granum-space/cansat-2017-2018/results/search-region/radius.png

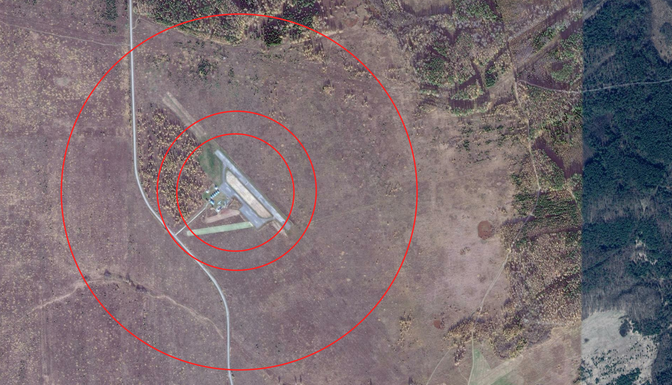
results/search-region/radius.png
