granum-space/cansat-2017-2018/documents/картинки/старые/gps.png

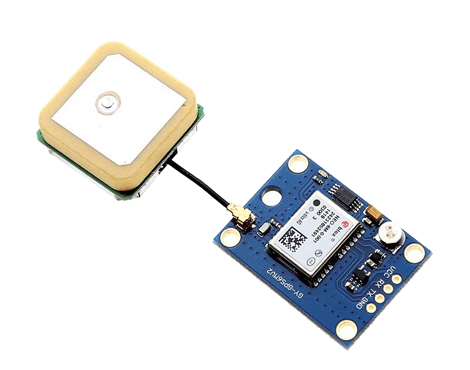
documents/картинки/старые/gps.png
