granum-space/cansat-2017-2018/README.md

# cansat-2018
Проект команды Granum чемпионата Cansat в России 2017-2018 года
