granum-space/cansat-2017-2018/src/board/servo_ctl/Project/stm8_granum_servo_ctl/readme.txt

Простой проект для управления сервой по i2c
