granum-space/cansat-2017-2018/research/archimedes screw/README.md

Исследование архимедова винта для подъема грунта для анализа
