granum-space/cansat-2017-2018/documents/mpu6000.jpg

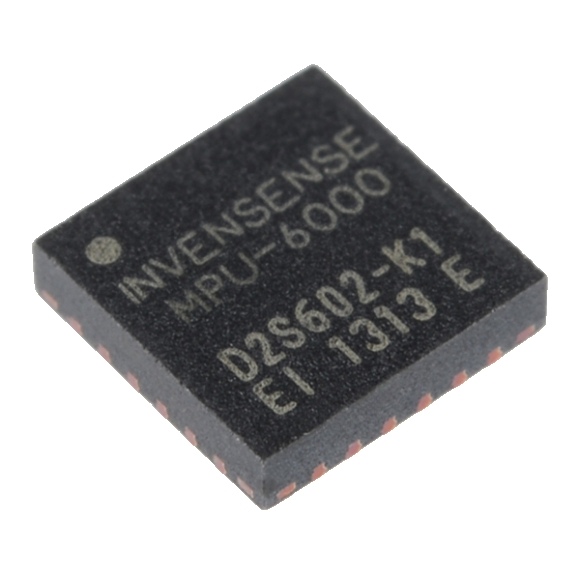
documents/mpu6000.jpg
