granum-space/cansat-2017-2018/documents/исходники схем/Линзы-на-слайд-2.png

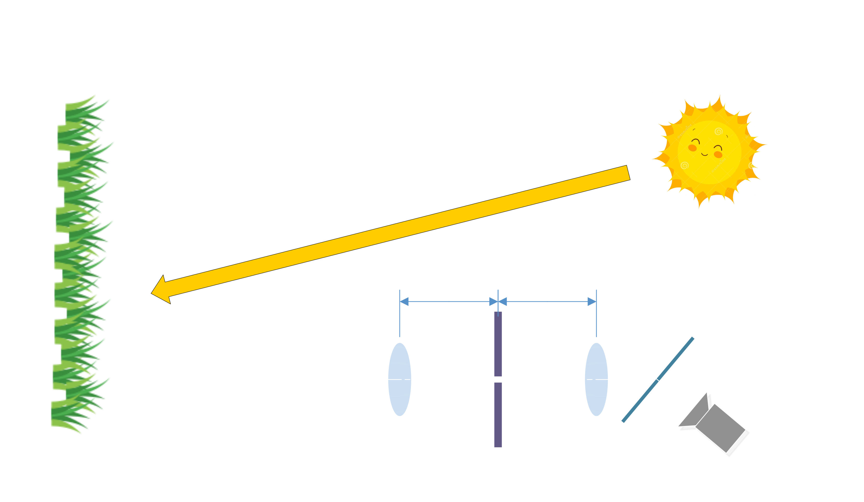
documents/исходники схем/Линзы-на-слайд-2.png
