granum-space/cansat-2017-2018/documents/исходники схем/Линзы-на-слайд.png

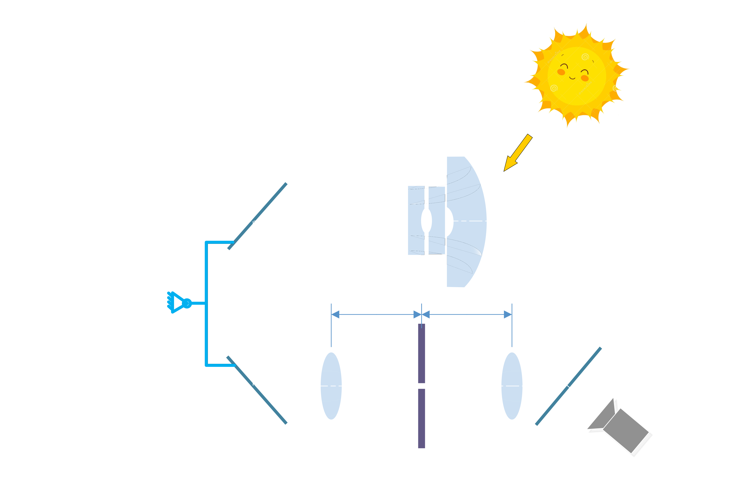
documents/исходники схем/Линзы-на-слайд.png
