granum-space/cansat-2017-2018/documents/исходники схем/Линзы-ПЗ.png

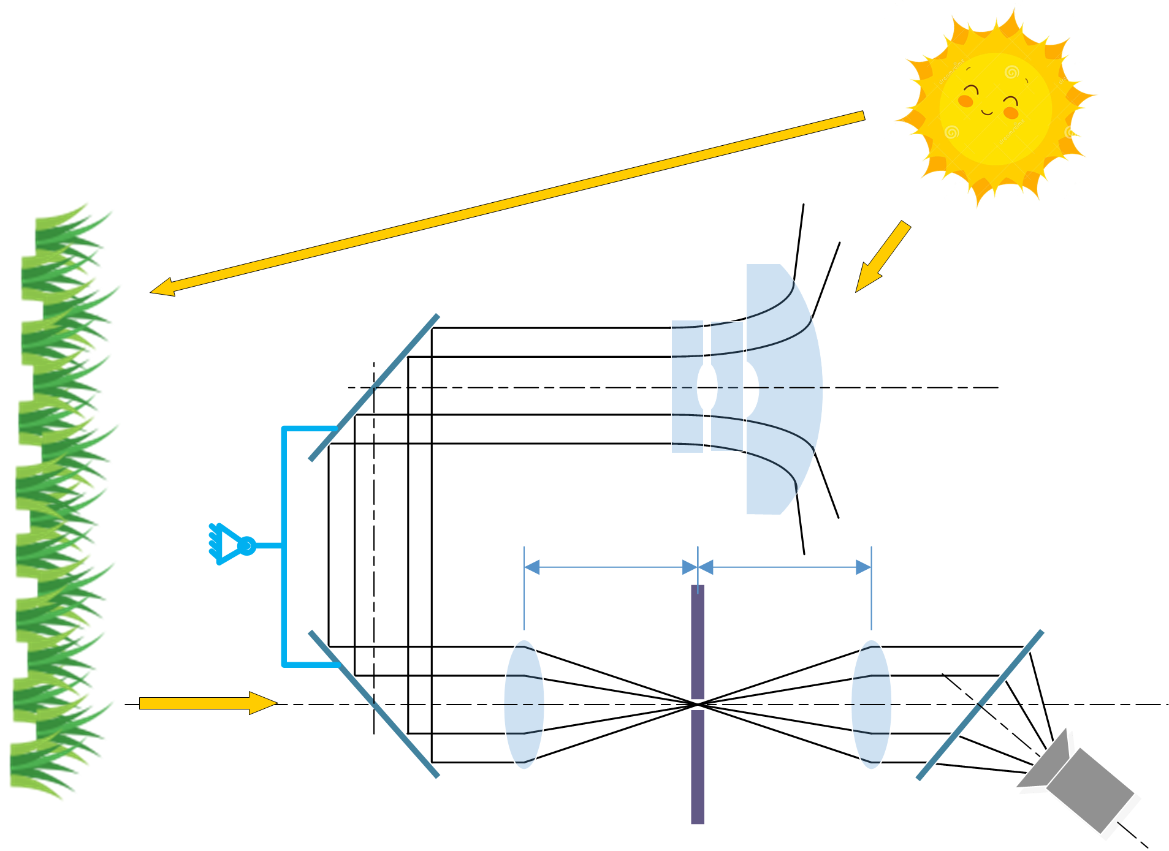
documents/исходники схем/Линзы-ПЗ.png
