granum-space/cansat-2017-2018/documents/картинки/bmp280.png

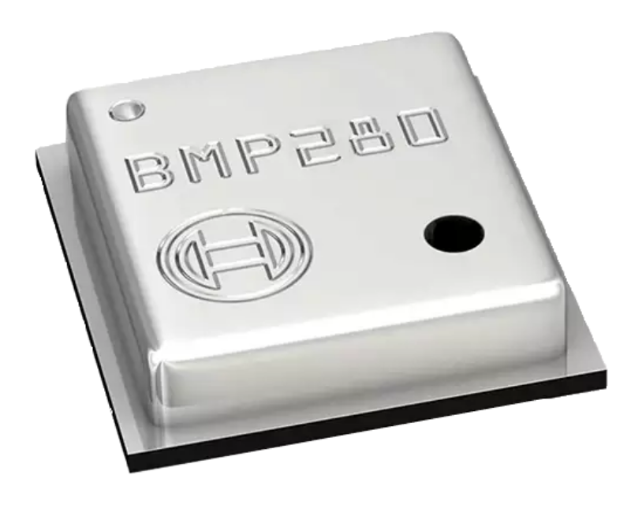
documents/картинки/bmp280.png
