granum-space/cansat-2017-2018/documents/картинки/microsd.png

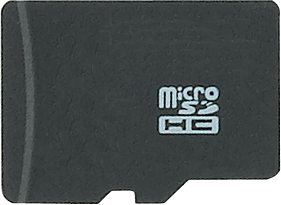
documents/картинки/microsd.png
