granum-space/cansat-2017-2018/documents/картинки/UART cam.jpg

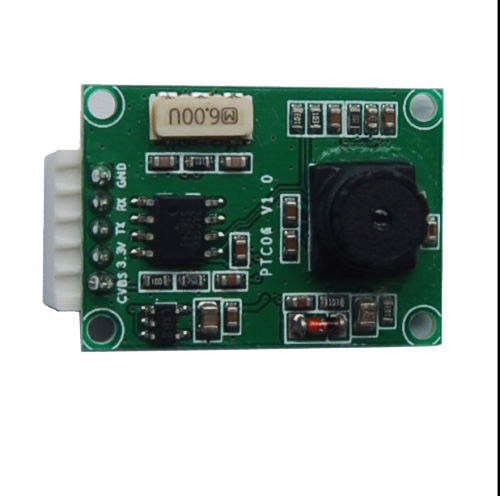
documents/картинки/UART cam.jpg
