granum-space/cansat-2017-2018/documents/картинки/Интернет.png

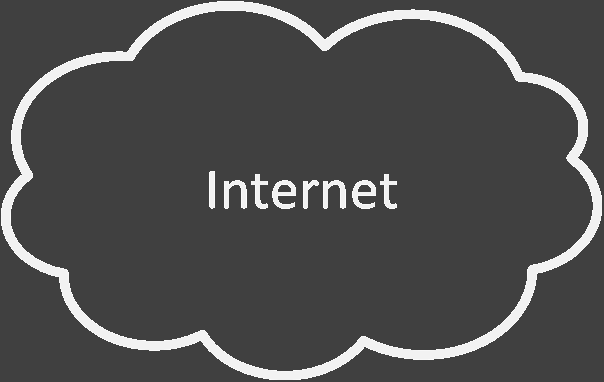
documents/картинки/Интернет.png
