granum-space/cansat-2017-2018/documents/картинки/Кабельная сеть.png

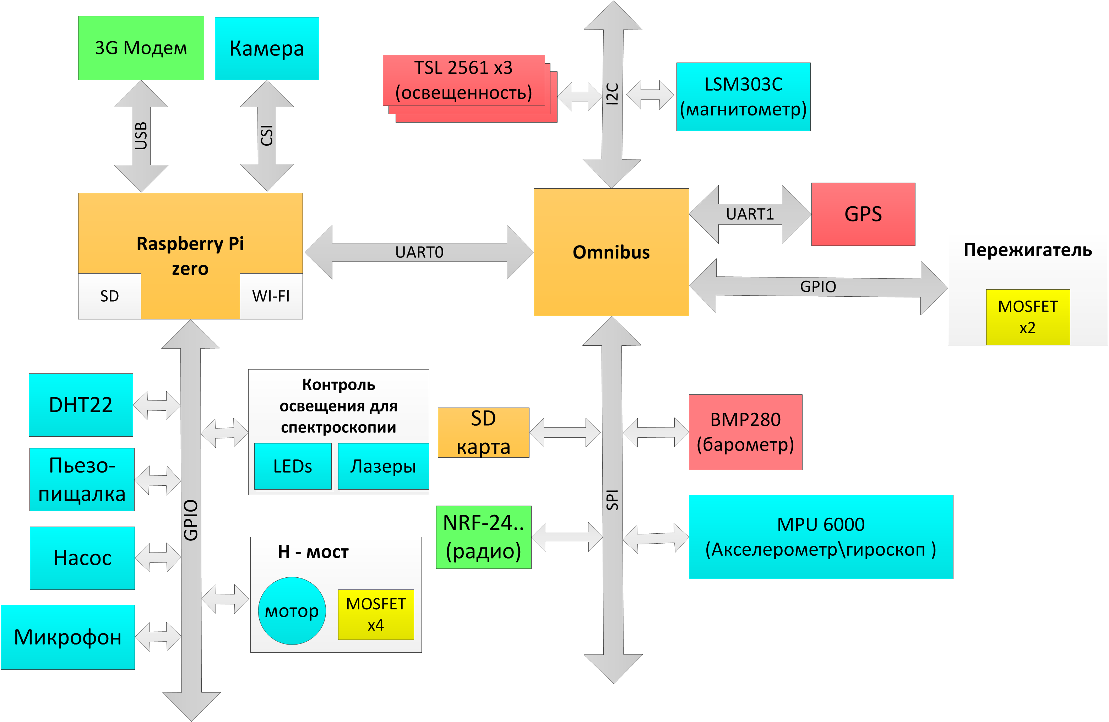
documents/картинки/Кабельная сеть.png
