granum-space/cansat-2017-2018/documents/картинки/наземка.png

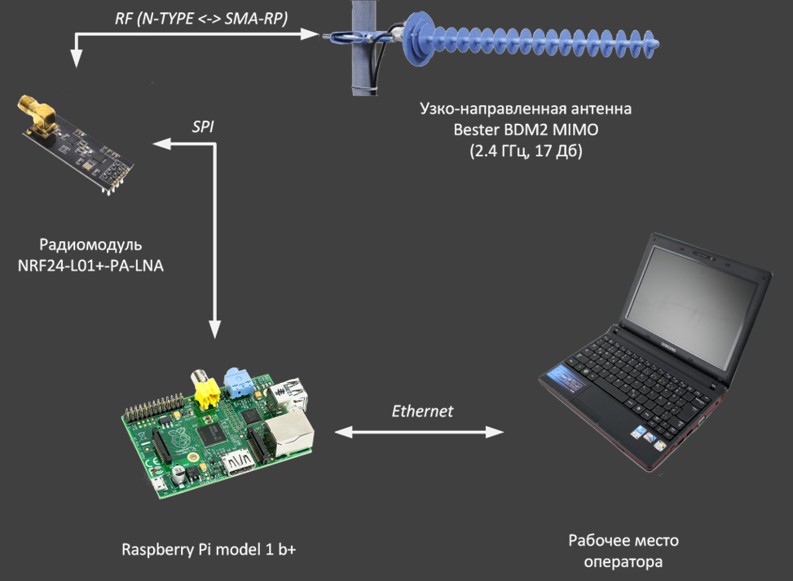
documents/картинки/наземка.png
