granum-space/cansat-2017-2018/documents/картинки/Наземная инфраструктура (для ПЗ).png

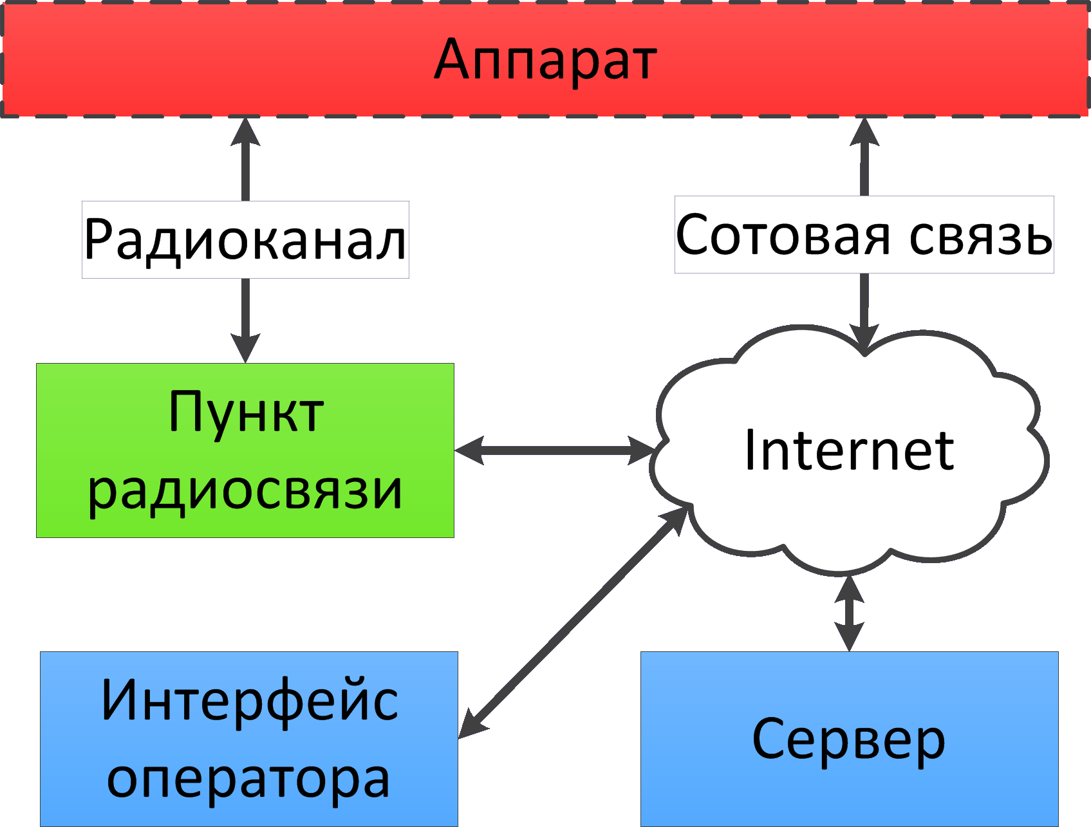
documents/картинки/Наземная инфраструктура (для ПЗ).png
