granum-space/cansat-2017-2018/documents/картинки/Наземная инфраструктура (для презентации).png

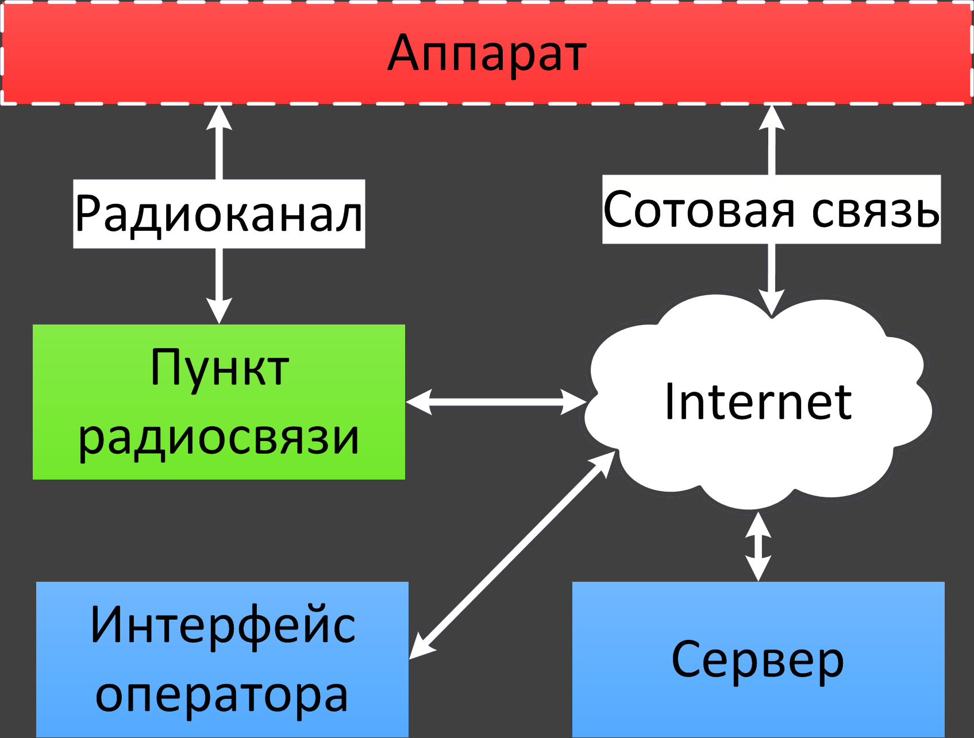
documents/картинки/Наземная инфраструктура (для презентации).png
