granum-space/cansat-2017-2018/documents/картинки/ПО презентация.png

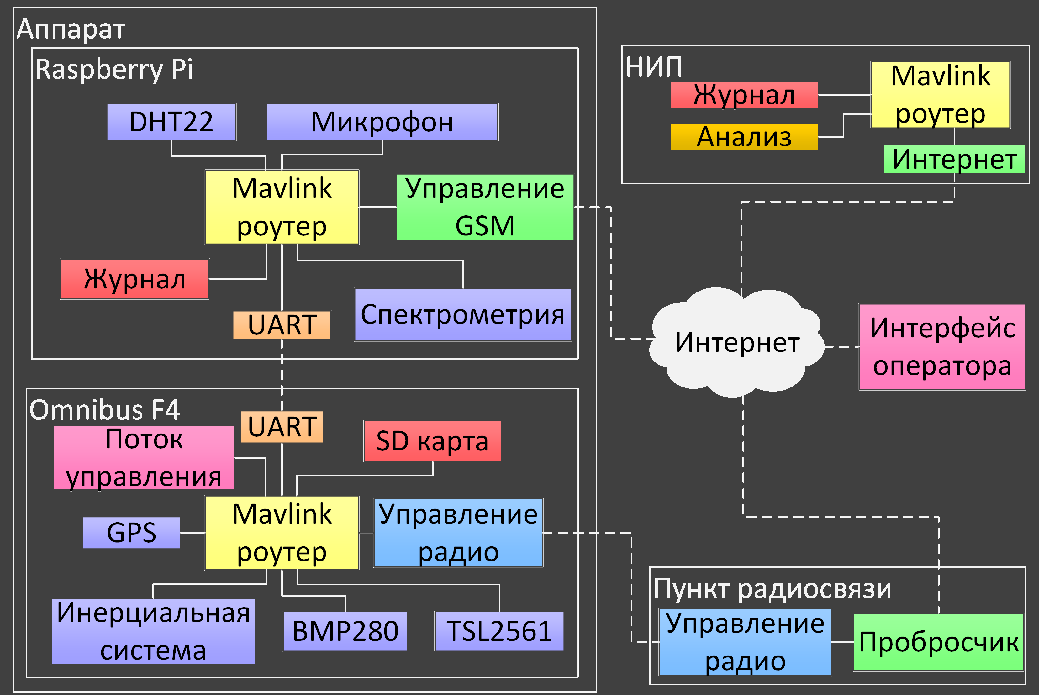
documents/картинки/ПО презентация.png
