granum-space/cansat-2017-2018/documents/картинки/ПО-ПЗ.png

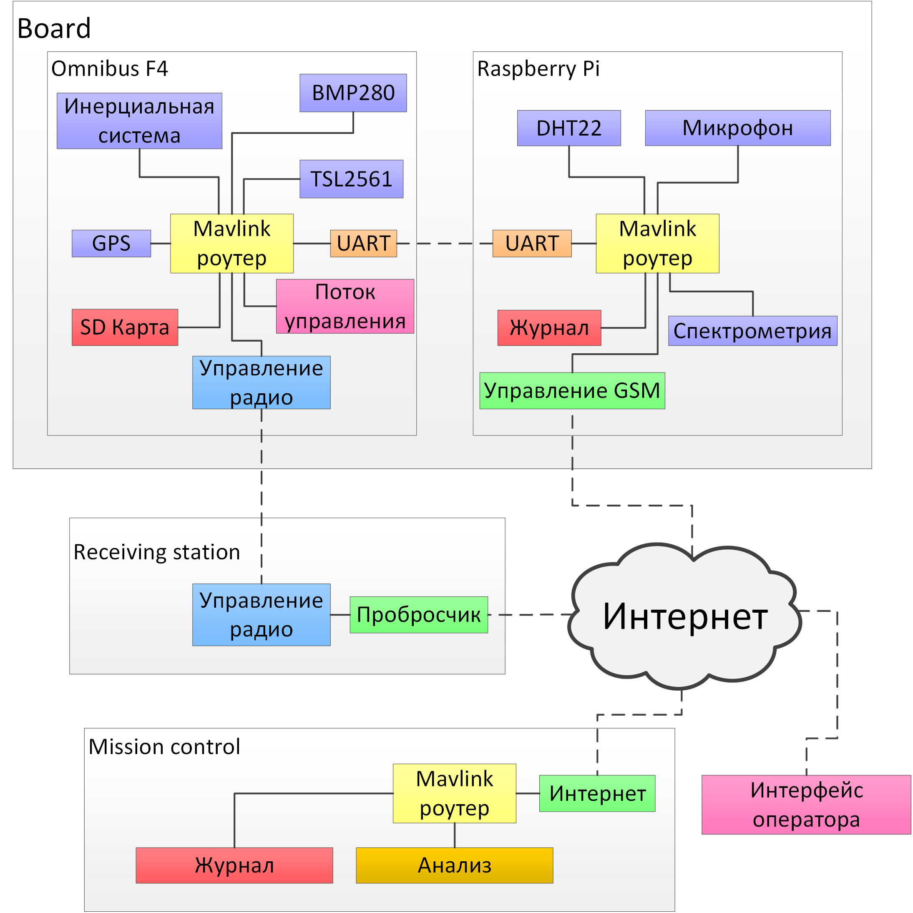
documents/картинки/ПО-ПЗ.png
