granum-space/cansat-2017-2018/documents/картинки/ПО.png

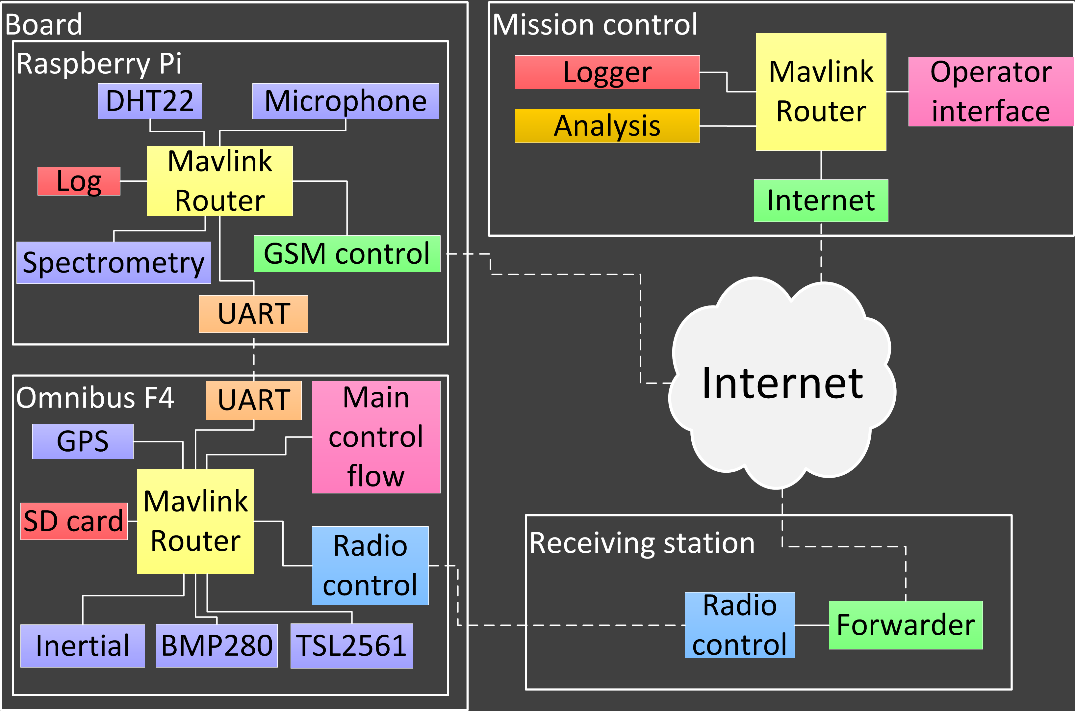
documents/картинки/ПО.png
