granum-space/cansat-2017-2018/documents/картинки/ПРС.png

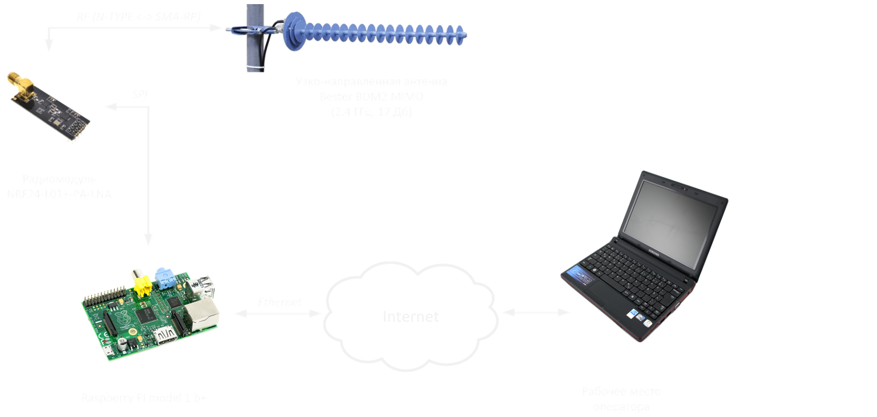
documents/картинки/ПРС.png
