granum-space/cansat-2017-2018/documents/картинки/расположение антенн.png

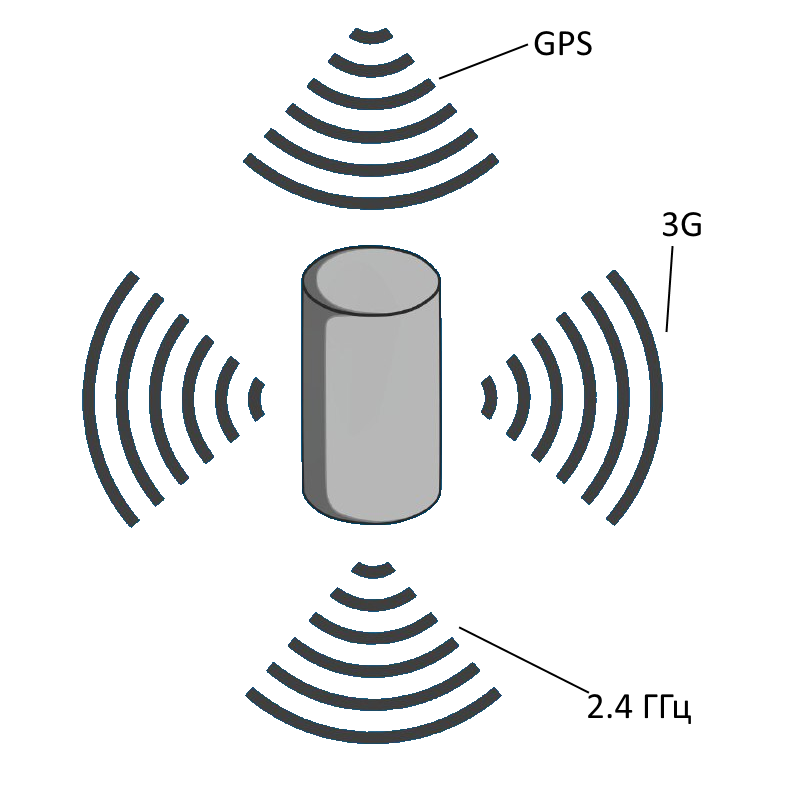
documents/картинки/расположение антенн.png
