granum-space/cansat-2017-2018/documents/картинки/спектрометр/water-soil.png

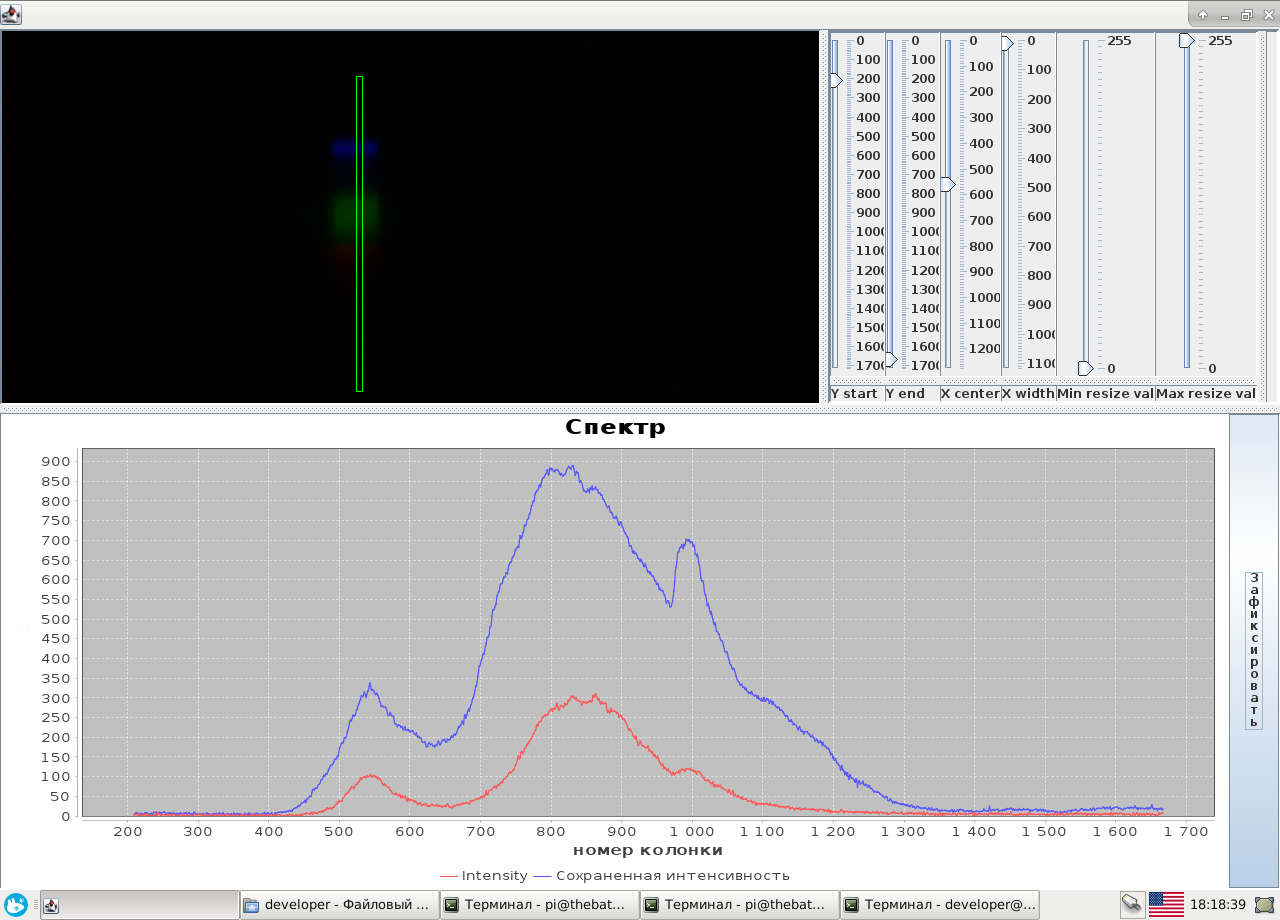
documents/картинки/спектрометр/water-soil.png
