granum-space/cansat-2017-2018/documents/картинки/спектрометр/люминесценция(без нм).png

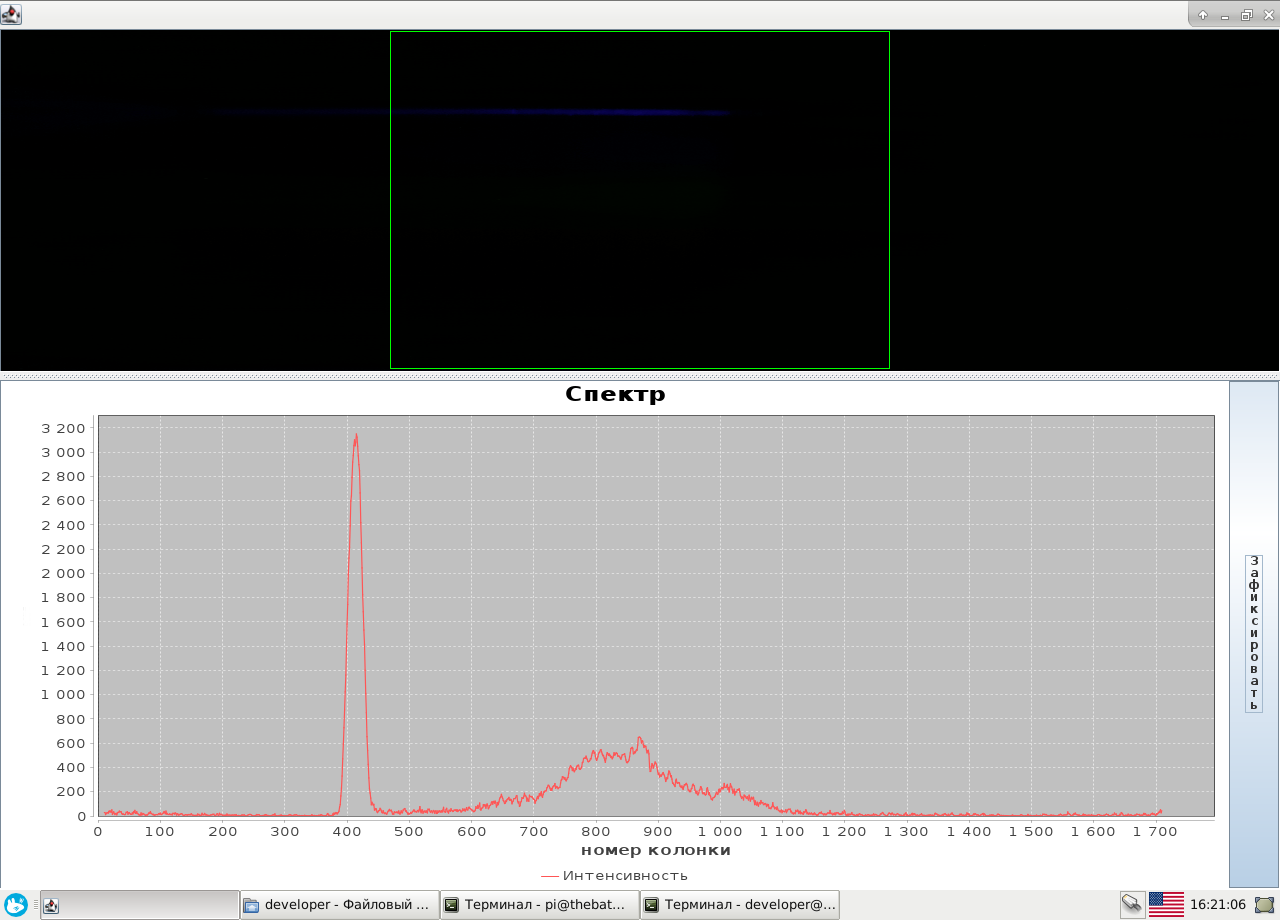
documents/картинки/спектрометр/люминесценция(без нм).png
