granum-space/cansat-2017-2018/documents/картинки/спектрометр/просветленная люминисценция.png

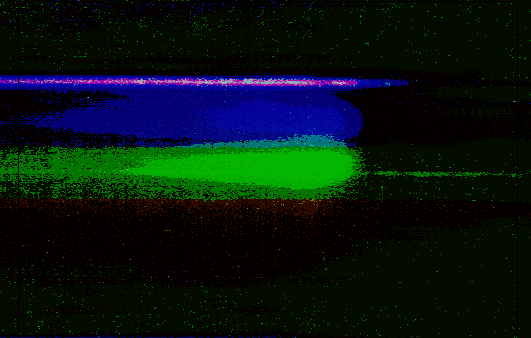
documents/картинки/спектрометр/просветленная люминисценция.png
