granum-space/cansat-2017-2018/documents/картинки/спектрометр/сберегательная лампа.png

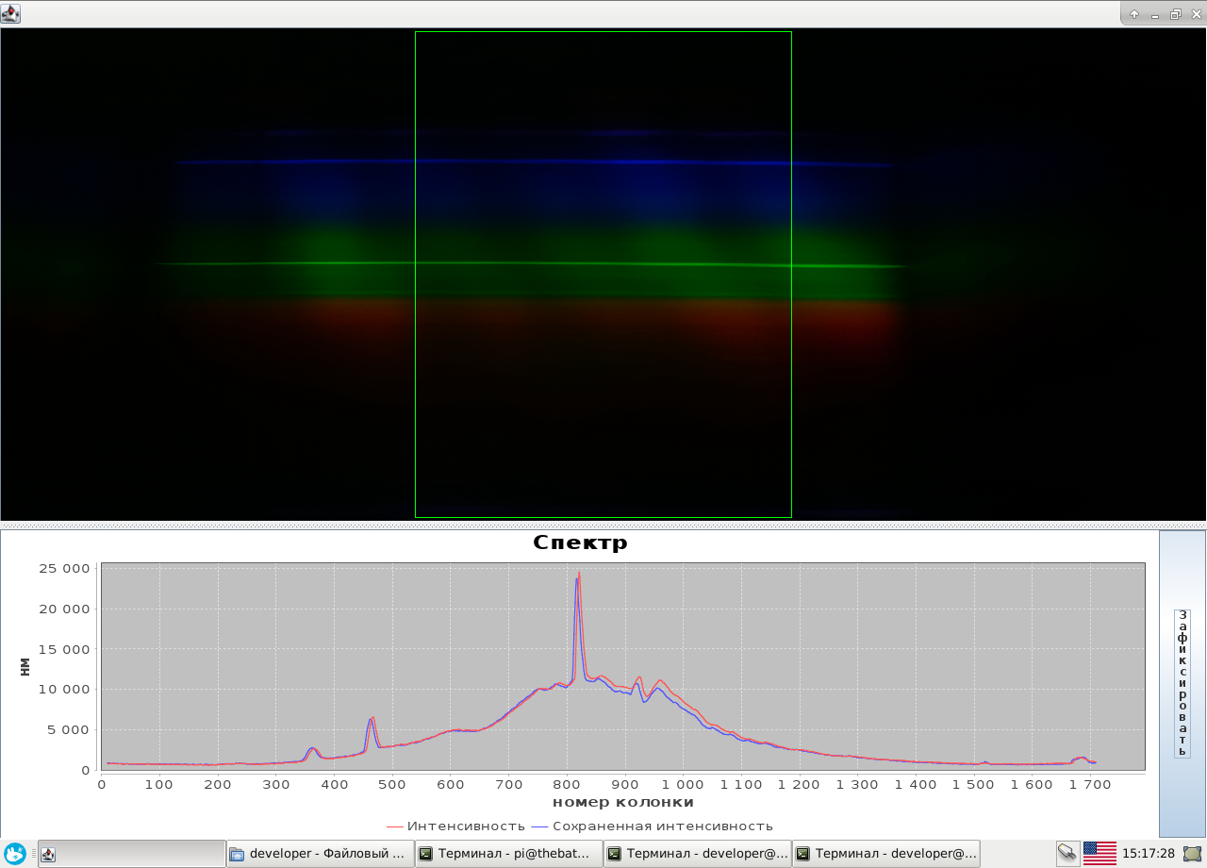
documents/картинки/спектрометр/сберегательная лампа.png
