granum-space/cansat-2017-2018/documents/картинки/спектрометр/спектр лазера 405 нм.png

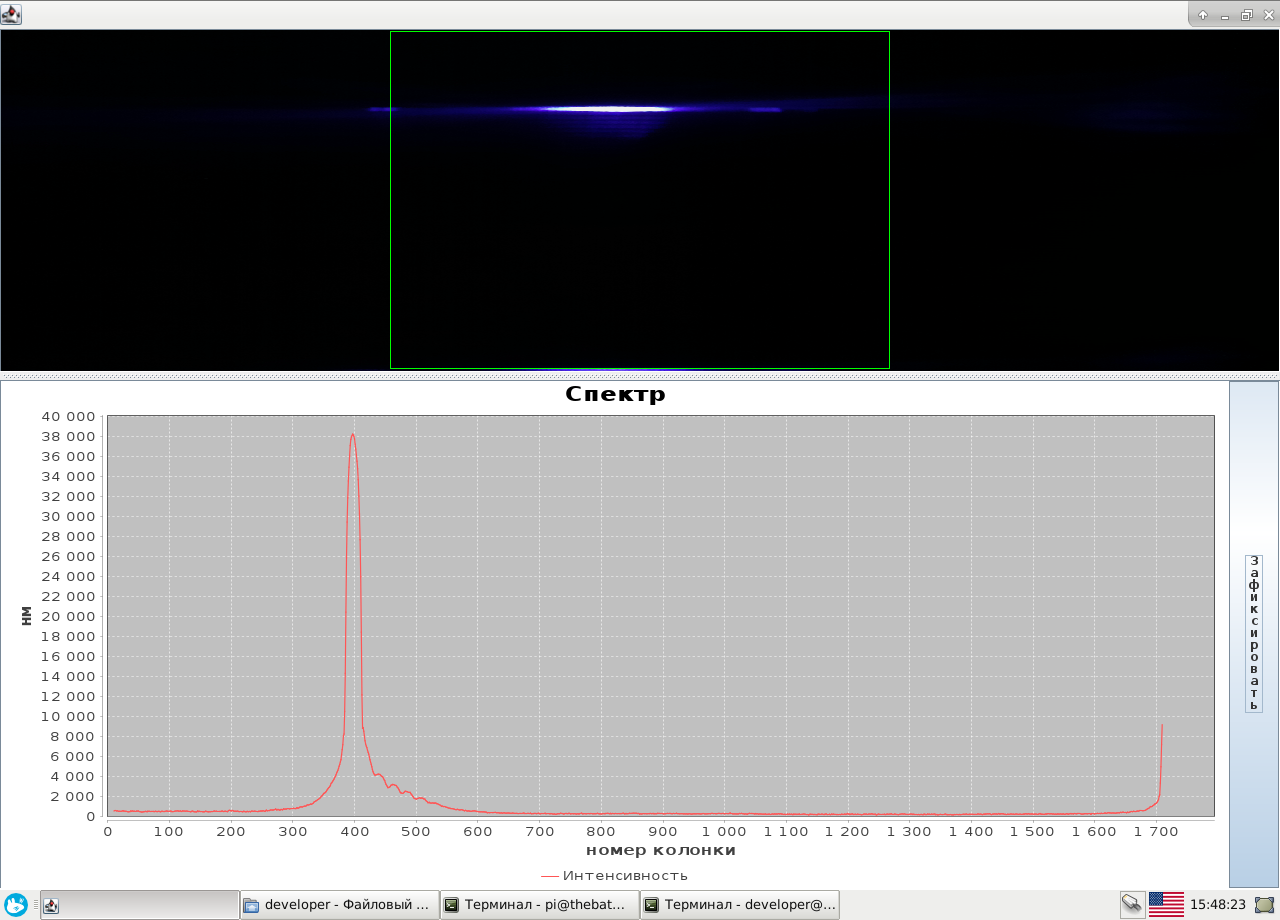
documents/картинки/спектрометр/спектр лазера 405 нм.png
