granum-space/cansat-2017-2018/documents/картинки/спектрометр/спектрометр2.png

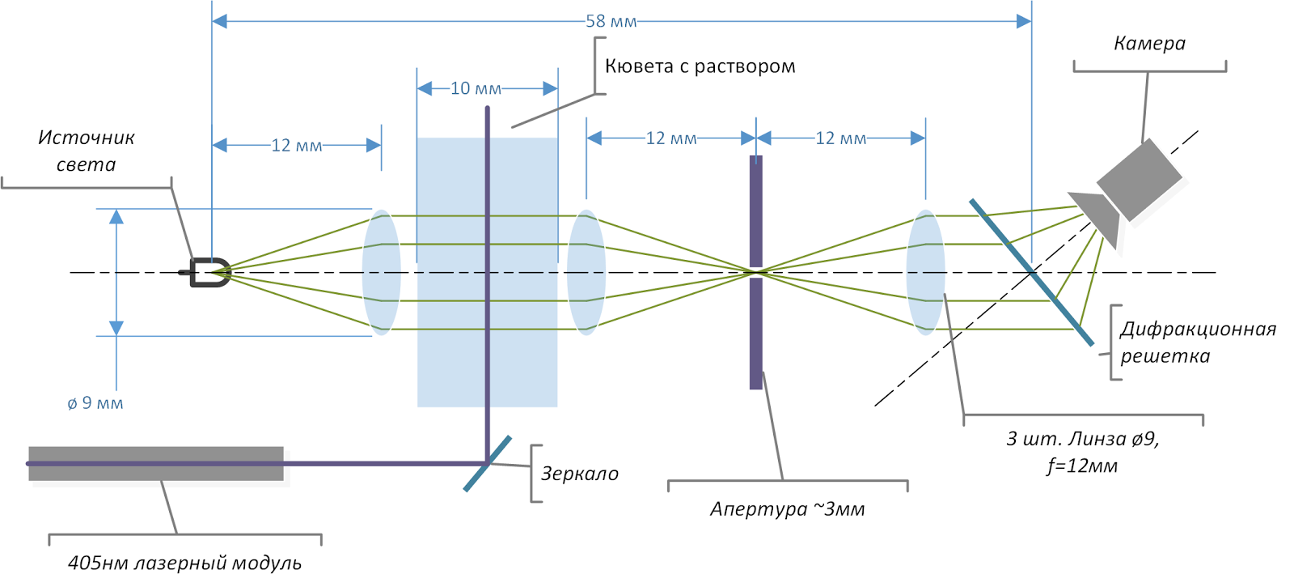
documents/картинки/спектрометр/спектрометр2.png
