granum-space/cansat-2017-2018/documents/картинки/спектрометр/фонарик с водичкой.png

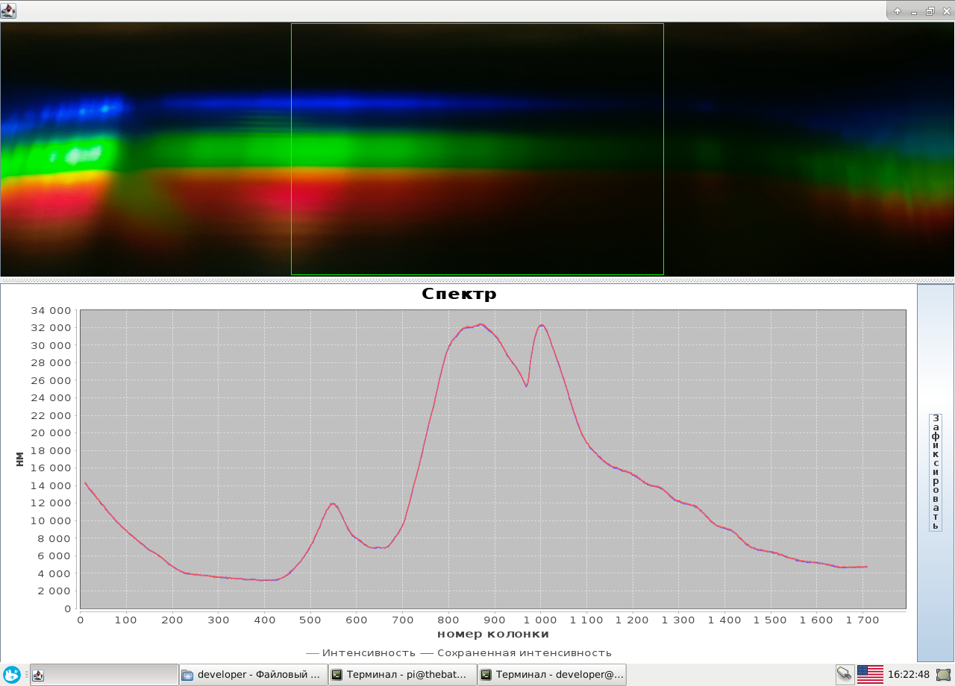
documents/картинки/спектрометр/фонарик с водичкой.png
