granum-space/cansat-2017-2018/documents/картинки/спектрометр/фонарик+лист= водичка и раствор.png

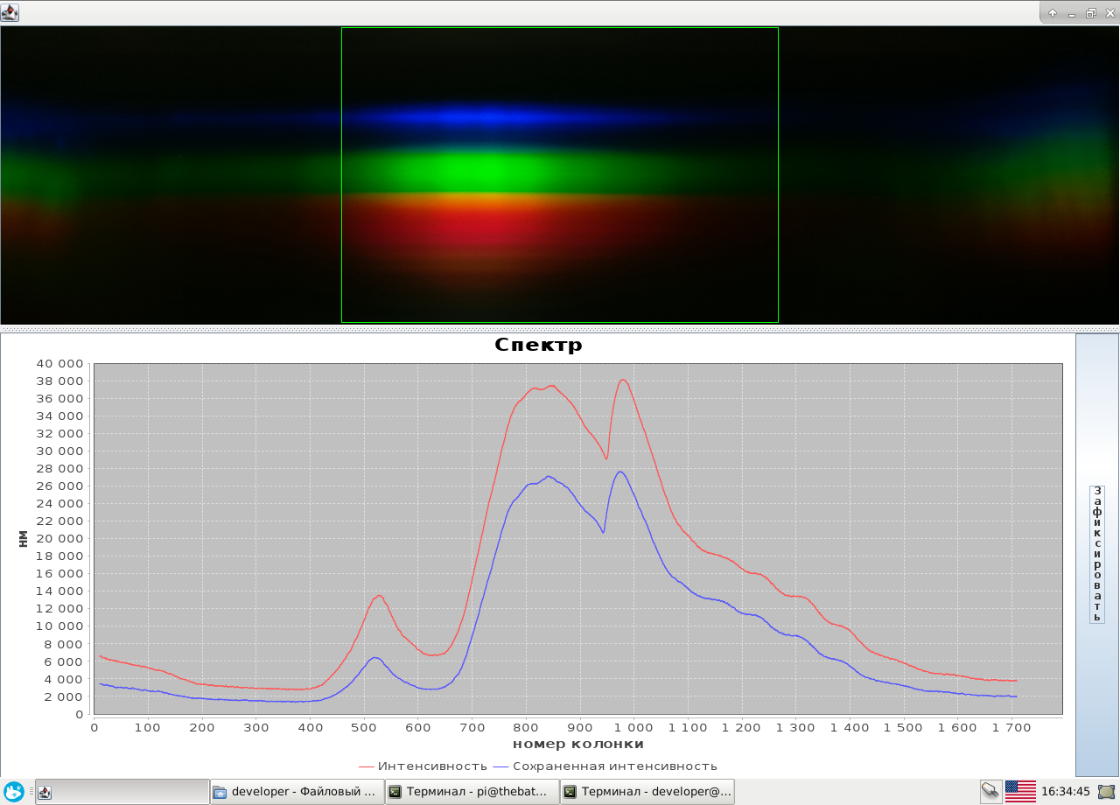
documents/картинки/спектрометр/фонарик+лист= водичка и раствор.png
