granum-space/cansat-2017-2018/documents/картинки/старые/antenna.png

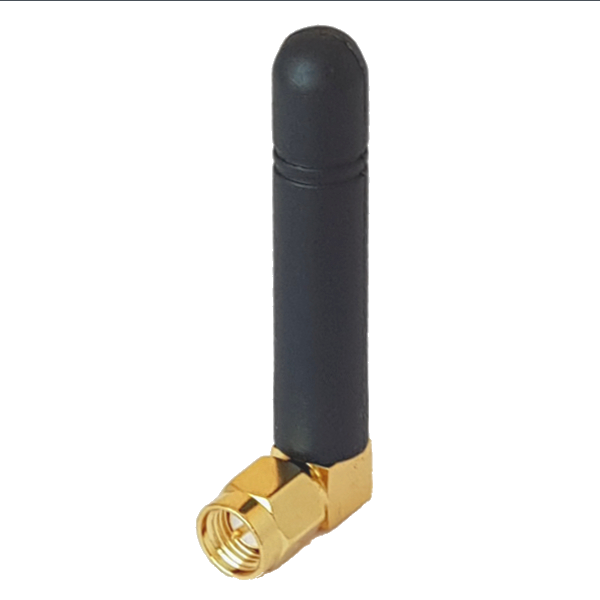
documents/картинки/старые/antenna.png
