granum-space/cansat-2017-2018/documents/картинки/старые/camera.png

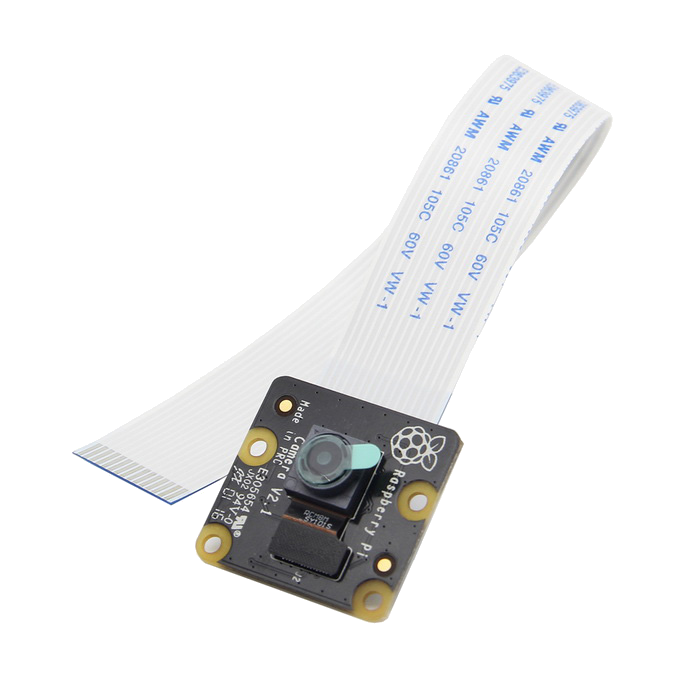
documents/картинки/старые/camera.png
