granum-space/cansat-2017-2018/documents/картинки/старые/DHT22.png

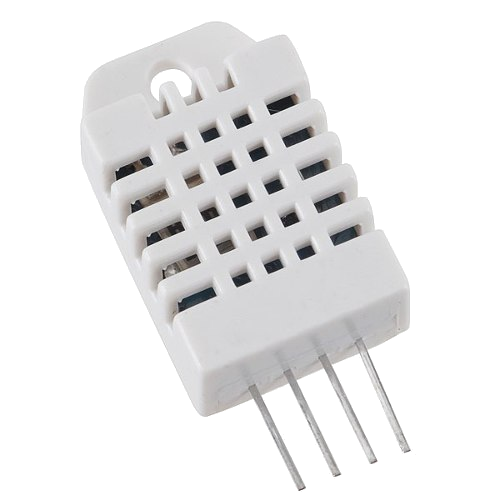
documents/картинки/старые/DHT22.png
