granum-space/cansat-2017-2018/documents/картинки/старые/GPS antenna.png

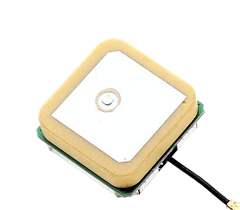
documents/картинки/старые/GPS antenna.png
