granum-space/cansat-2017-2018/documents/картинки/старые/gps board.png

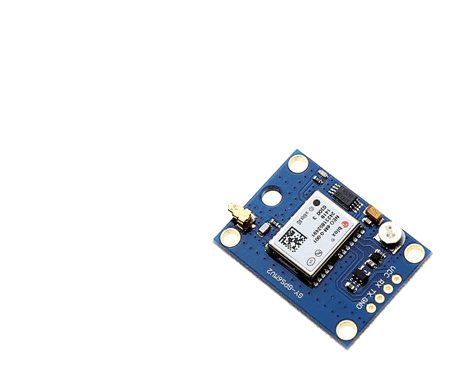
documents/картинки/старые/gps board.png
