granum-space/cansat-2017-2018/documents/картинки/старые/Granum architecture 2018 + СУДН, СЭП...png

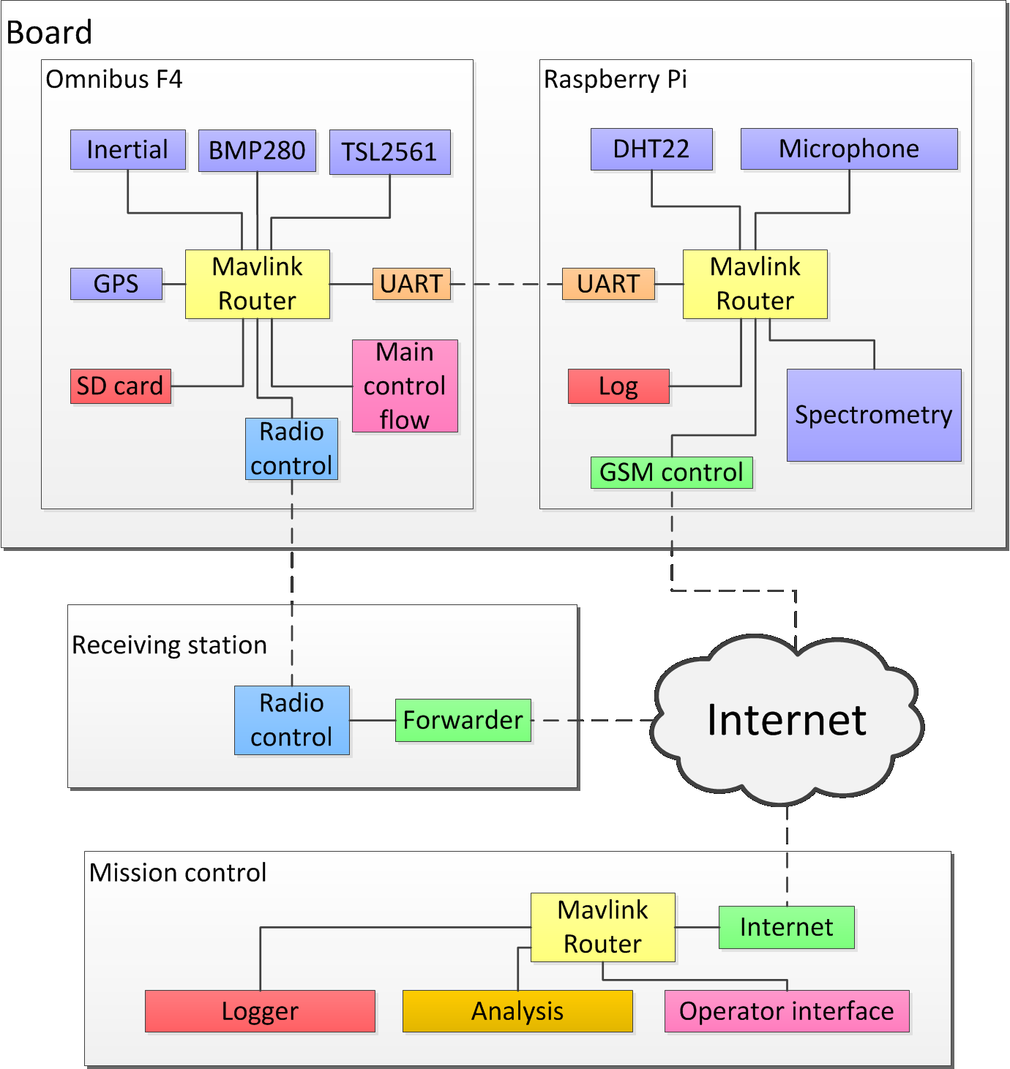
documents/картинки/старые/Granum architecture 2018 + СУДН, СЭП...png
