granum-space/cansat-2017-2018/documents/картинки/старые/lsm303c.png

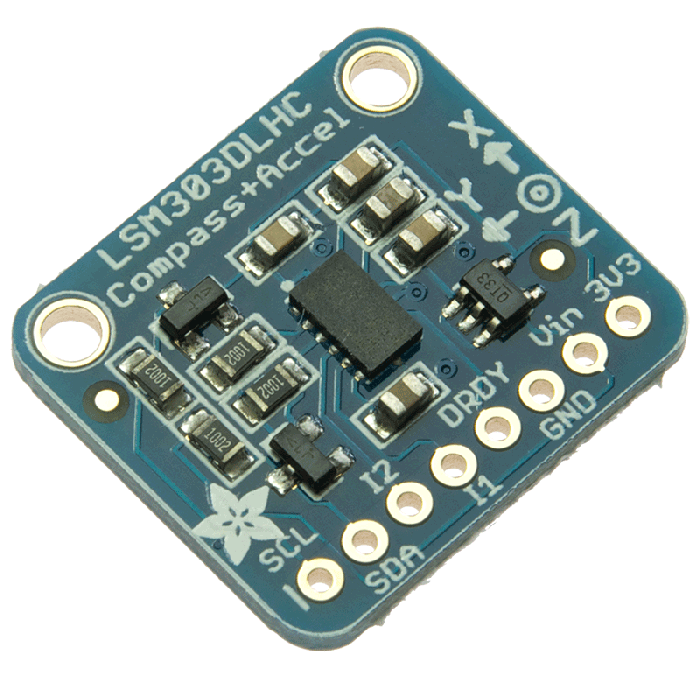
documents/картинки/старые/lsm303c.png
