granum-space/cansat-2017-2018/documents/картинки/старые/microphone.png

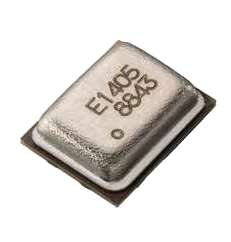
documents/картинки/старые/microphone.png
