granum-space/cansat-2017-2018/documents/картинки/старые/modem.png

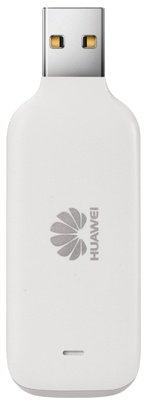
documents/картинки/старые/modem.png
