granum-space/cansat-2017-2018/documents/картинки/старые/nrf.png

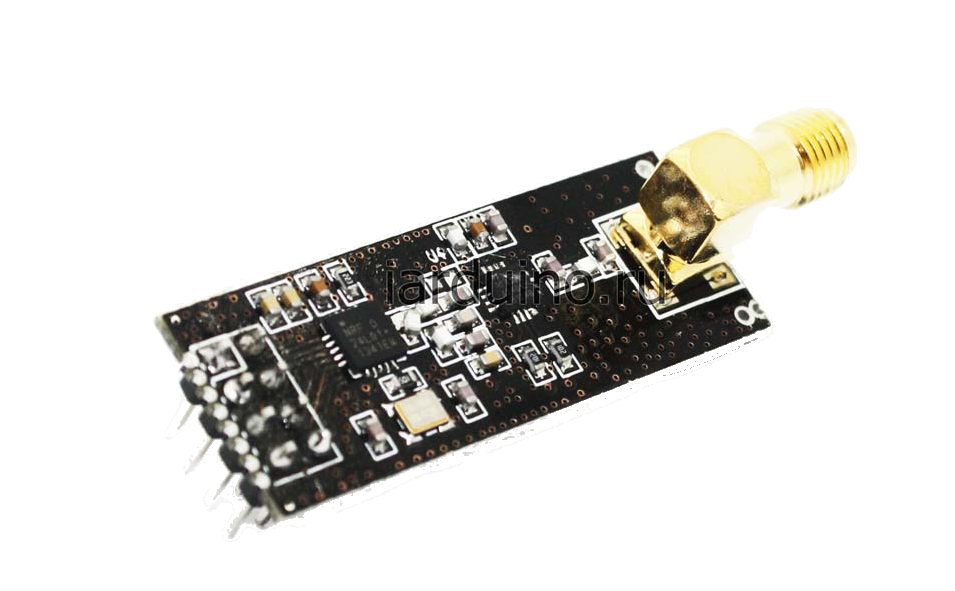
documents/картинки/старые/nrf.png
