granum-space/cansat-2017-2018/documents/картинки/старые/omnibus.png

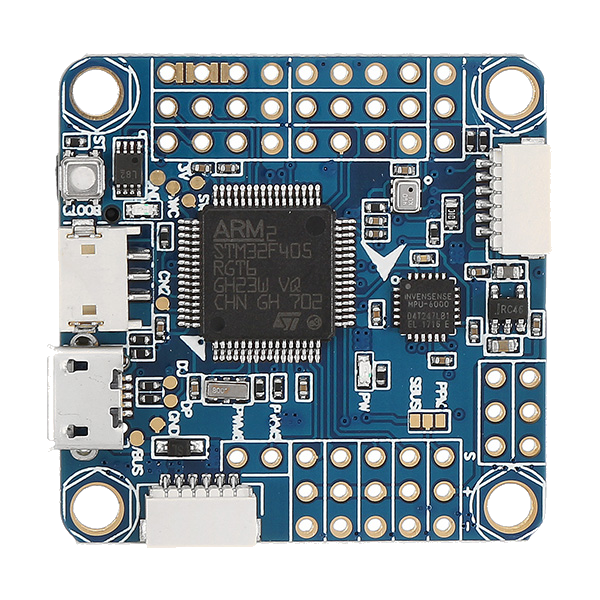
documents/картинки/старые/omnibus.png
