granum-space/cansat-2017-2018/documents/картинки/старые/piezo.png

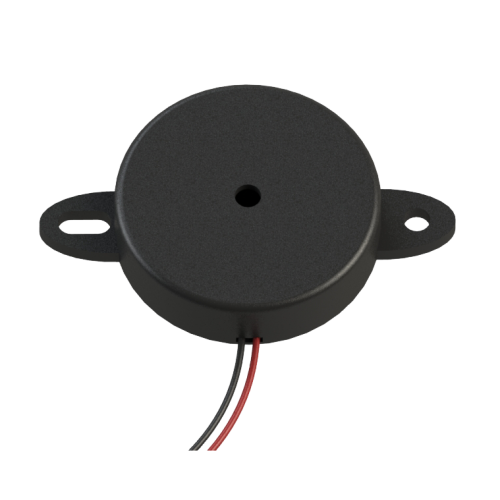
documents/картинки/старые/piezo.png
