granum-space/cansat-2017-2018/documents/картинки/старые/pump.png

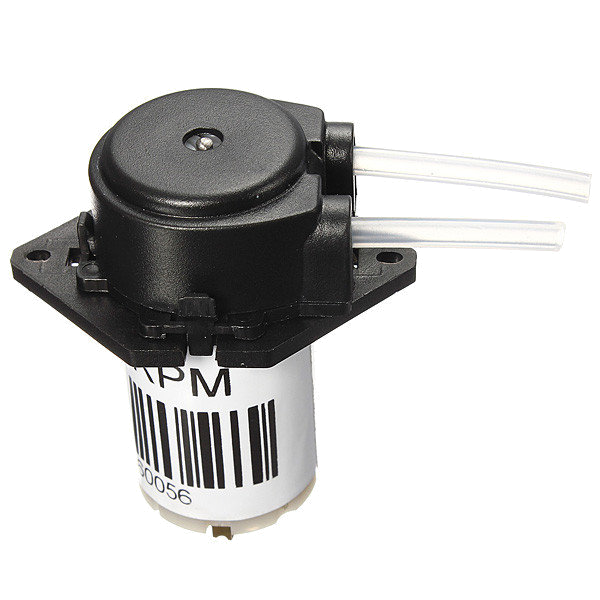
documents/картинки/старые/pump.png
