granum-space/cansat-2017-2018/documents/картинки/старые/tsl2561.png

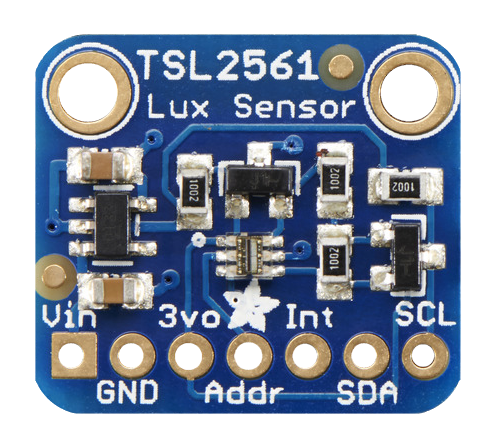
documents/картинки/старые/tsl2561.png
