granum-space/cansat-2017-2018/documents/картинки/старые/архитектура.jpg

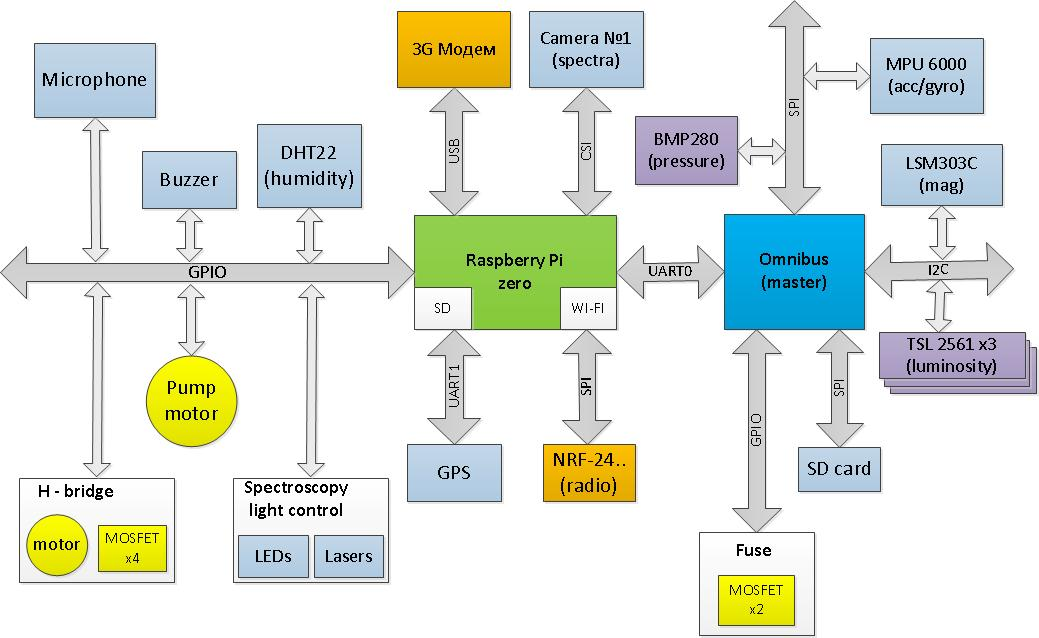
documents/картинки/старые/архитектура.jpg
