granum-space/cansat-2017-2018/documents/картинки/СУБА.png

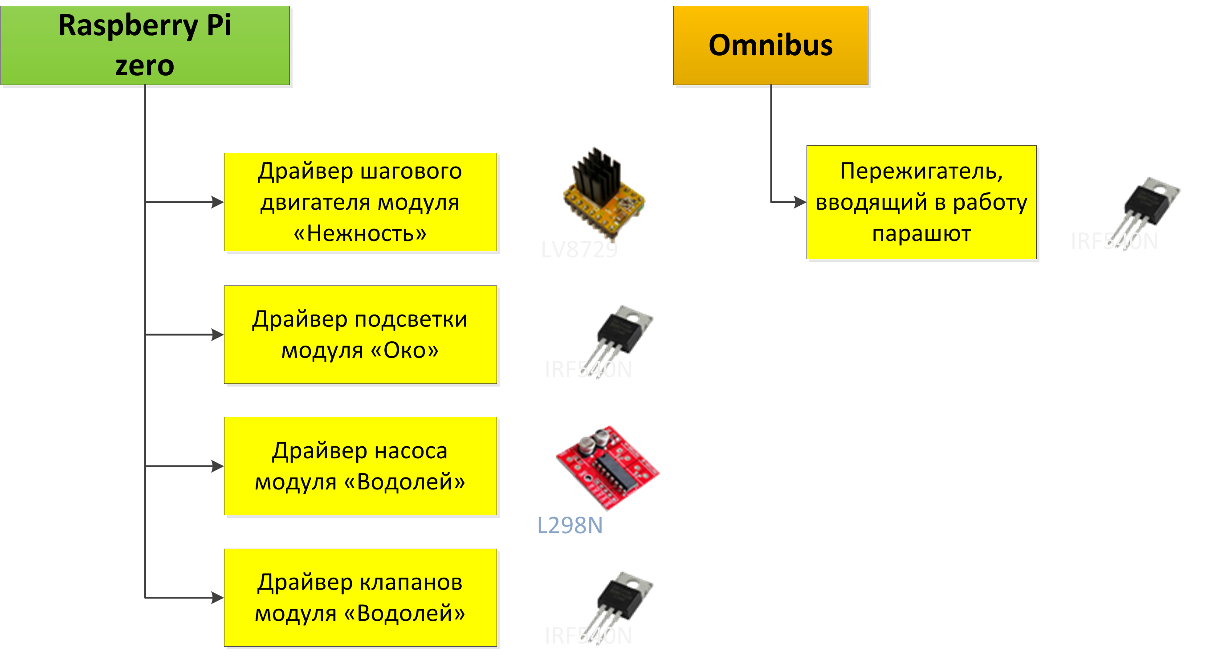
documents/картинки/СУБА.png
