granum-space/cansat-2017-2018/documents/картинки/СУДН.png

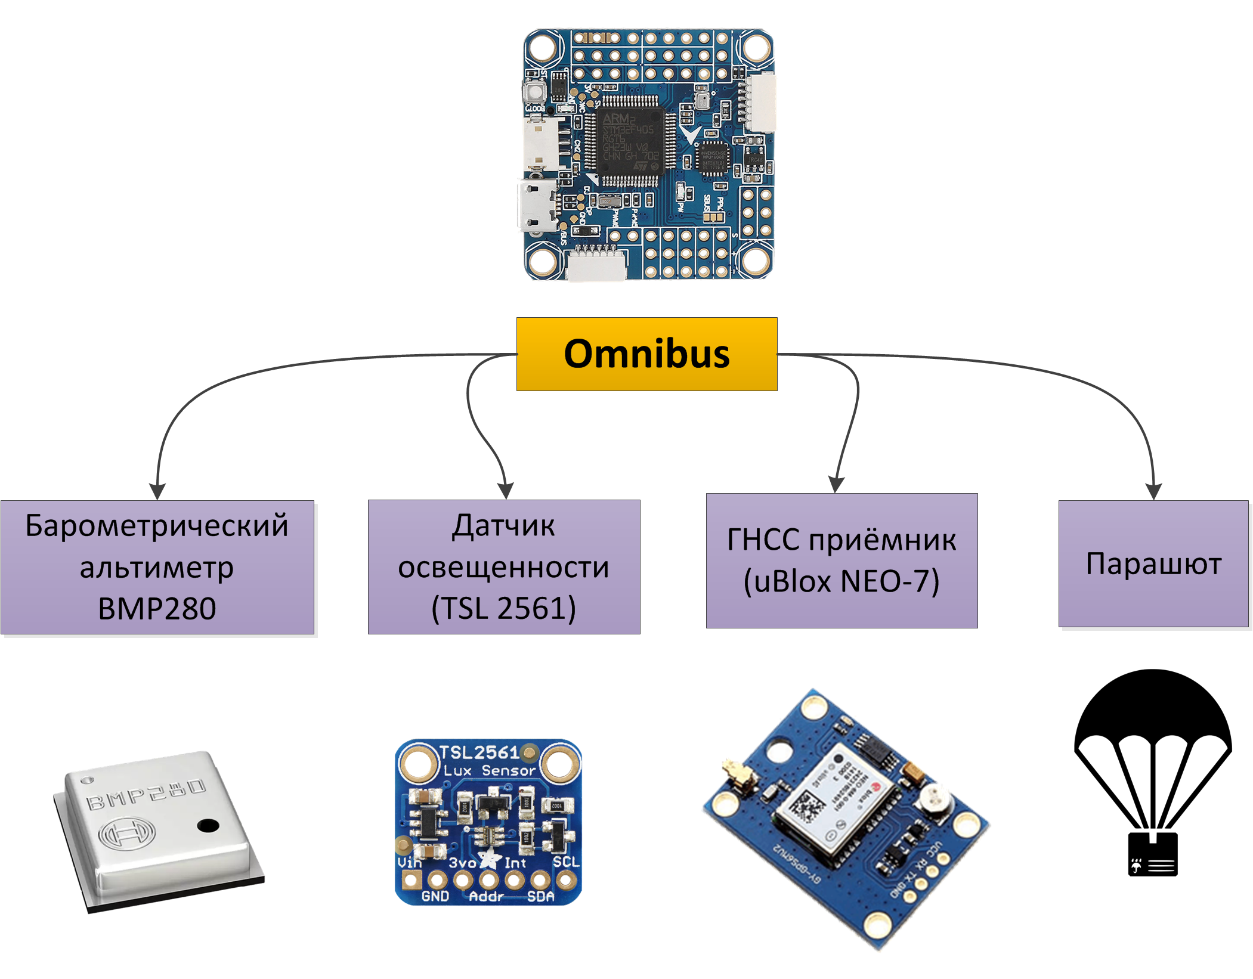
documents/картинки/СУДН.png
