granum-space/cansat-2017-2018/research/Madgwick/dump-processor/theplane.stl

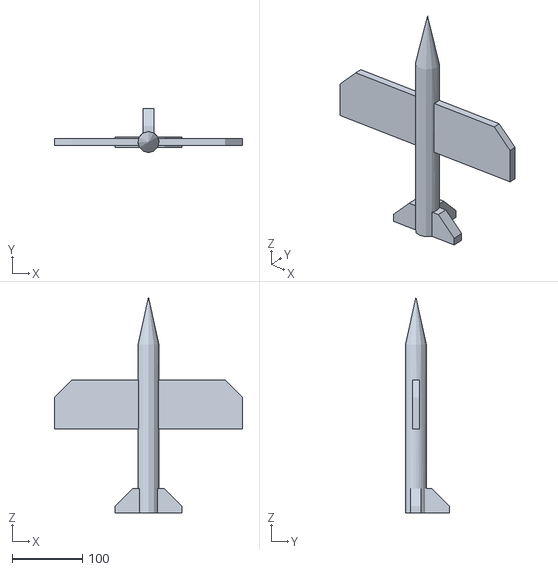
[picture p64: CAD file, 2017-11-06]
research/Madgwick/dump-processor/theplane.stl
268.3 x 63.0 x 308.0
