granum-space/cansat-2017-2018/results/attitude-plotter/cansat.stl

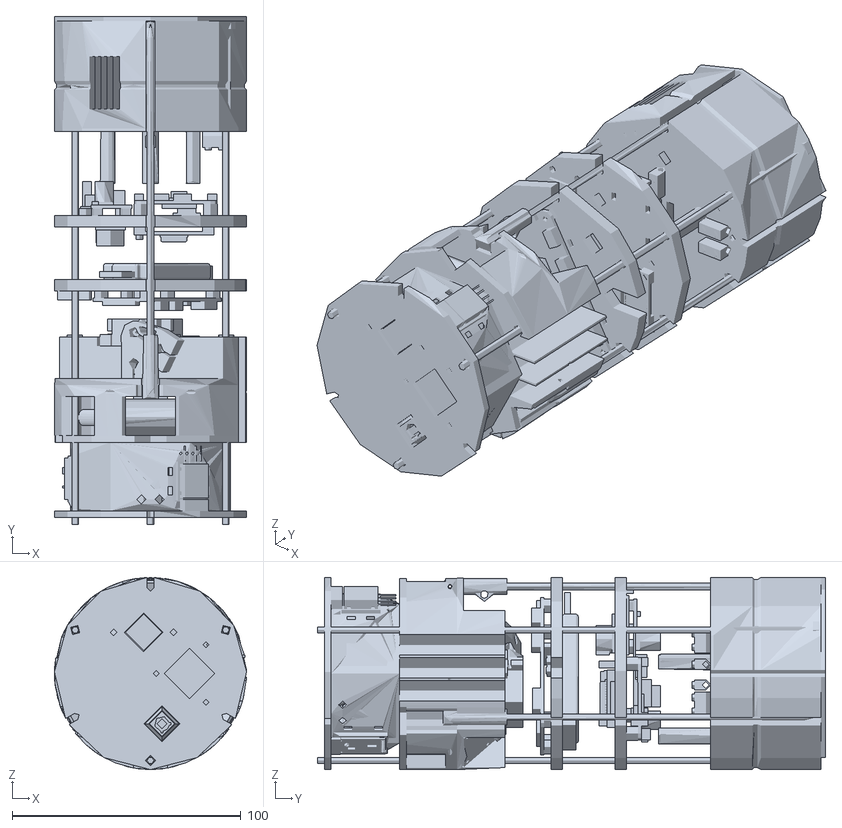
[picture p65: CAD file, 2018-06-04]
results/attitude-plotter/cansat.stl
84.0 x 222.0 x 84.0
