granum-space/cansat-2017-2018/src/ground/drainbow_mcc/src/drainbow_mcc/webapp/static/rocket.stl

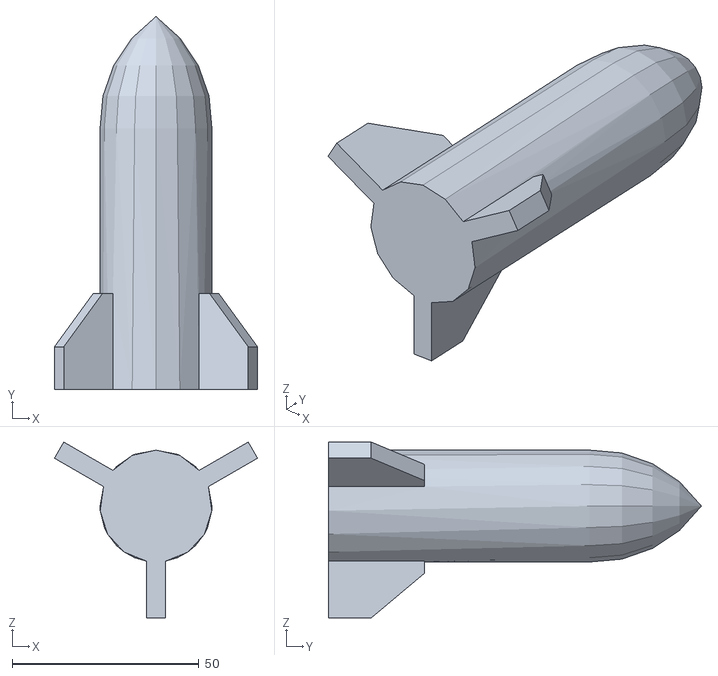
[picture p66: CAD file, 2018-05-01]
src/ground/drainbow_mcc/src/drainbow_mcc/webapp/static/rocket.stl
54.5 x 100.0 x 47.2
