granum-space/cansat-2017-2018/structure/print/new_chute2_case.stl

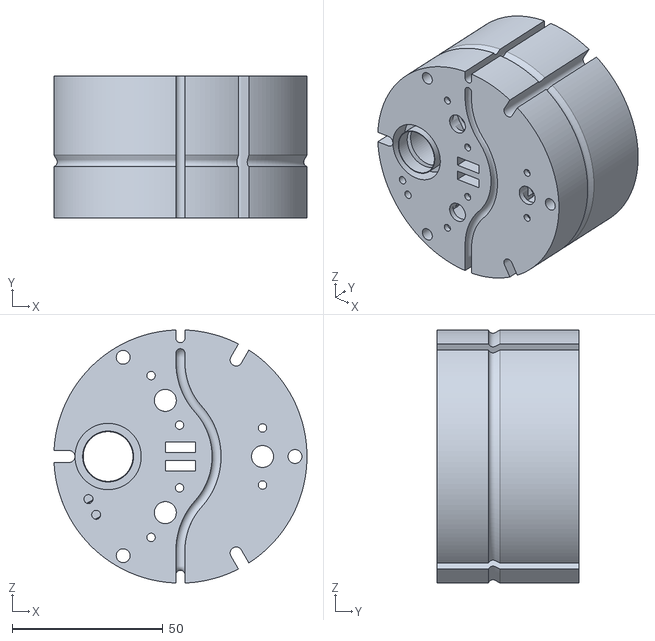
[picture p67: CAD file, 2018-05-29]
structure/print/new_chute2_case.stl
84.0 x 47.0 x 83.9
