granum-space/cansat-2017-2018/structure/support/spectro_base_bottom_print.stl

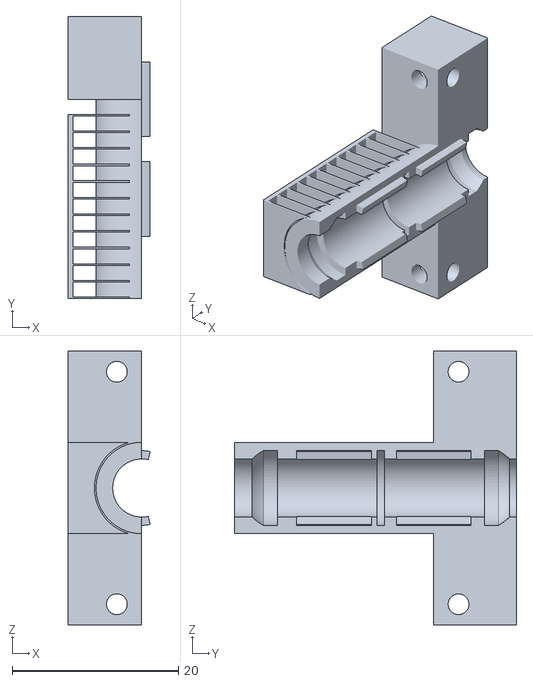
[picture p68: CAD file, 2018-02-22]
structure/support/spectro_base_bottom_print.stl
9.91 x 34.0 x 33.0
