granum-space/cansat-2017-2018/structure/print/bottom-plane_new.stl

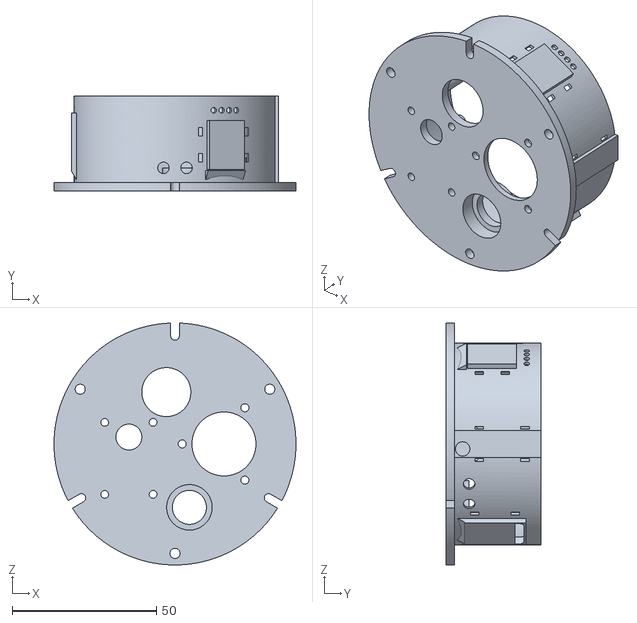
[picture p69: CAD file, 2018-04-21]
structure/print/bottom-plane_new.stl
84.0 x 32.9 x 84.0
