granum-space/cansat-2017-2018/structure/support/spectro_base_top_print.stl

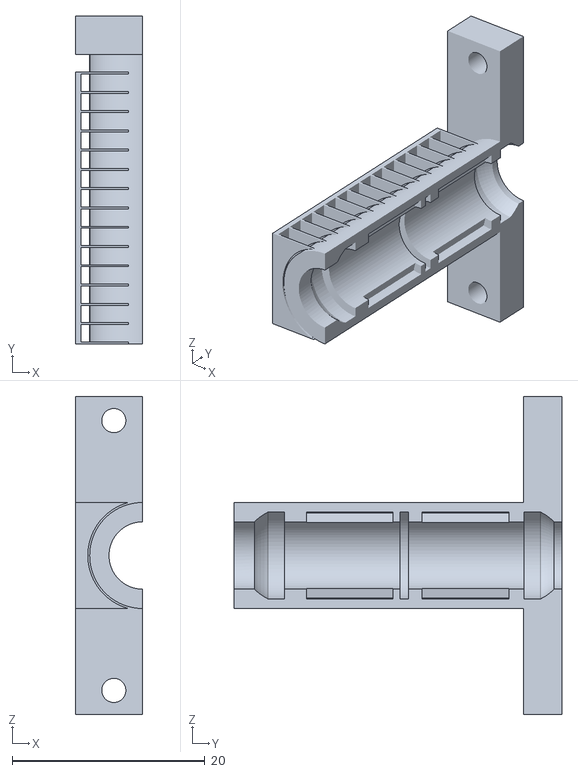
[picture p70: CAD file, 2018-02-22]
structure/support/spectro_base_top_print.stl
7.00 x 34.0 x 33.0
