granum-space/cansat-2017-2018/(list of files, cad)

Other CAD files:
src/board/servo_ctl/Project/STM8S_StdPeriph_Template/STVD/Cosmic/stm8af622x.stp
src/board/servo_ctl/Project/STM8S_StdPeriph_Template/STVD/Raisonance/stm8s105.stp
src/board/servo_ctl/Project/STM8S_StdPeriph_Template/STVD/Cosmic/stm8s003.stp
src/board/servo_ctl/Project/STM8S_StdPeriph_Template/STVD/Raisonance/stm8s207.stp
src/board/servo_ctl/Project/STM8S_StdPeriph_Template/STVD/Cosmic/stm8af62ax.stp
src/board/servo_ctl/Project/STM8S_StdPeriph_Template/STVD/Raisonance/stm8af62ax.stp
src/board/servo_ctl/Project/STM8S_StdPeriph_Template/STVD/Cosmic/stm8af52ax.stp
src/board/servo_ctl/Project/STM8S_StdPeriph_Template/STVD/Raisonance/stm8s003.stp
src/board/servo_ctl/Project/STM8S_StdPeriph_Template/STVD/Cosmic/stm8af626x.stp
src/board/servo_ctl/Project/STM8S_StdPeriph_Template/STVD/Raisonance/stm8s903.stp
src/board/servo_ctl/Project/STM8S_StdPeriph_Template/STVD/Cosmic/stm8s005.stp
src/board/servo_ctl/Project/STM8S_StdPeriph_Template/STVD/Raisonance/stm8af52ax.stp
src/board/servo_ctl/Project/STM8S_StdPeriph_Template/STVD/Cosmic/stm8s103.stp
src/board/servo_ctl/Project/STM8S_StdPeriph_Template/STVD/Raisonance/stm8s005.stp
src/board/servo_ctl/Project/STM8S_StdPeriph_Template/STVD/Cosmic/stm8s007.stp
src/board/servo_ctl/Project/STM8S_StdPeriph_Template/STVD/Raisonance/stm8s208.stp
src/board/servo_ctl/Project/STM8S_StdPeriph_Template/STVD/Cosmic/stm8s208.stp
src/board/servo_ctl/Project/STM8S_StdPeriph_Template/STVD/Raisonance/stm8s007.stp
src/board/servo_ctl/Project/STM8S_StdPeriph_Template/STVD/Cosmic/stm8s207.stp
src/board/servo_ctl/Project/STM8S_StdPeriph_Template/STVD/Raisonance/stm8af622x.stp
src/board/servo_ctl/Project/STM8S_StdPeriph_Template/STVD/Cosmic/stm8s105.stp
src/board/servo_ctl/Project/STM8S_StdPeriph_Template/STVD/Raisonance/stm8s103.stp
src/board/servo_ctl/Project/STM8S_StdPeriph_Template/STVD/Cosmic/stm8s903.stp
src/board/servo_ctl/Project/STM8S_StdPeriph_Template/STVD/Raisonance/stm8af626x.stp
research/archimedes screw/archimedes_case.prt
research/archimedes screw/casing.prt
research/archimedes screw/casing_motor.prt
research/archimedes screw/motor.prt
research/archimedes screw/vint.prt
structure/all/am2320.prt
structure/all/antenn.prt
structure/all/antenna_gps.prt
structure/all/battery_base.prt
structure/all/battery_case.prt
structure/all/battery_new.prt
structure/all/battery_protection.prt
structure/all/beeper.prt
structure/all/bottom-plane_new.prt
structure/all/bottom-plane_nnew.prt
structure/all/cam_cover_neww.prt
structure/all/camdet_down_new.prt
structure/all/camera_cmos.prt
structure/all/camm_kron.prt
structure/all/camm_kron1.prt
structure/all/chute2_case_new.prt
structure/all/den1.prt
structure/all/den12.prt
structure/all/dht22.prt
structure/all/dlastergney_new.prt
structure/all/electro_platform.prt
structure/all/electronics_new1.prt
structure/all/gps_ublox_neo-7m-0-000.prt
structure/all/grating.prt
structure/all/grating_cover_neww.prt
structure/all/grating_neww.prt
structure/all/gsm_antenn.prt
structure/all/holder.prt
structure/all/holder1.prt
structure/all/holder_case_botoom.prt
structure/all/holder_rails.prt
structure/all/hpa17.prt
structure/all/huawei_e173.prt
structure/all/huawei_e173_cased.prt
structure/all/huawei_e3533.prt
structure/all/key_nut.prt
structure/all/klutch.prt
structure/all/lens_bottom.prt
structure/all/lens_bottom_case.prt
structure/all/lm2596_dc-dc.prt
structure/all/lsm303c.prt
structure/all/microphone_sph0645.prt
structure/all/mirror_case0.prt
structure/all/new_chute2_case.prt
structure/all/new_peephole.prt
structure/all/new_platform.prt
structure/all/new_spring.prt
structure/all/new_thehope_cover.prt
structure/all/nrf24l01.prt
structure/all/nrf_case.prt
structure/all/omnibus.prt
structure/all/peephole_new.prt
structure/all/pig_tail_gsm.prt
structure/all/pipe_holder1.prt
structure/all/platform.prt
structure/all/platform_new.prt
structure/all/rasberry-pi_zero_w.prt
structure/all/round_robin_new.prt
structure/all/seeds_servo_new.prt
structure/all/serva.prt
structure/all/sonar.prt
structure/all/sp.prt
structure/all/spectro-plane_new.prt
structure/all/spectro_body.prt
structure/all/spectro_body_bottom.prt
structure/all/spectro_body_top.prt
structure/all/spectromete_base_bottom_neww.prt
structure/all/spectromete_base_top_neww.prt
structure/all/spring_new.prt
structure/all/stm8.prt
structure/all/strut_new.prt
structure/all/textolit.prt
structure/all/thehope_cover.prt
structure/all/tsl2561.prt
structure/all/voltage_regulator.prt
structure/all/weights_home.prt
structure/all/zond_new.prt
structure/support/spectro_base_bottom_support.prt
structure/support/spectro_base_top_support.prt
structure/другой вариант спектрометра/camera_neww.prt
structure/другой вариант спектрометра/camm_kron.prt
structure/другой вариант спектрометра/grating.prt
structure/другой вариант спектрометра/len_new.prt
structure/другой вариант спектрометра/seeds_servo_new.prt
structure/другой вариант спектрометра/slit_neww.prt
structure/другой вариант спектрометра/spectrometer1.prt
