granum-space/cansat-2017-2018/results/attitude-plotter/ATTITUDE_QUATERNION.csv

time_boot_ms | q1 | q2 | q3 | q4 | rollspeed | pitchspeed | yawspeed
0 | -0.010306891985238 | 0.058170884847641 | -0.731464743614197 | 0.676986455917358 | 0 | 0 | 0
0 | -0.010971738956869 | 0.058897253125906 | -0.731359899044037 | 0.677026689052582 | 0 | 0 | 0
0 | -0.011783736757934 | 0.059683848172426 | -0.731576383113861 | 0.676710784435272 | 0 | 0 | 0
0 | -0.012471354566515 | 0.060161326080561 | -0.731433987617493 | 0.676809847354889 | 0 | 0 | 0
0 | -0.013397850096226 | 0.060820117592812 | -0.731581449508667 | 0.676573395729065 | 0 | 0 | 0
0 | -0.014118859544396 | 0.061066634953022 | -0.73174524307251 | 0.67635977268219 | 0 | 0 | 0
0 | -0.014439785853028 | 0.061778388917446 | -0.731531858444214 | 0.676519215106964 | 0 | 0 | 0
0 | -0.015204005874693 | 0.06248514726758 | -0.731660068035126 | 0.676299095153809 | 0 | 0 | 0
0 | -0.015854470431805 | 0.063606567680836 | -0.731943190097809 | 0.675872504711151 | 0 | 0 | 0
0 | -0.01629146002233 | 0.064555570483208 | -0.731997013092041 | 0.675714015960693 | 0 | 0 | 0
0 | -0.016924075782299 | 0.065519280731678 | -0.732016623020172 | 0.675584256649017 | 0 | 0 | 0
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
