granum-space/cansat-2017-2018/(threads)

Thread 1 (2017-10-03):

Построить спектрометр и убедиться в возможности в нашей технологии спектрального анализа почвы

Snork2, 2017-10-03:
TODO: Добавить ссылок на рабочие материалы

Snork2, 2017-10-17:
Новый этап - построить спектрометр из пластика и проверить его на просвет лазером

Snork2, 2017-10-31:
Нашли очень интересный эффект, который можно эксплуатировать: люминисценция гуминов.

Нашлось довольно много статей с описанием этого эффекта. Эта очень неплохая: http://citeseerx.ist.psu.edu/viewdoc/download?doi=10.1.1.532.9379&rep=rep1&type=pdf

Согласно ей, достаточно сильная люминисценция наблюдается при облучении раствора гуминов излучением с длиннами волн 400 - 460нм.
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

Это диапазон доступный для LED лазеров. [Лазеры заказаны](https://www.aliexpress.com/item/3PCS-Green-Blue-Violet-Red-Light-Beam-Powerful-5MW-Laser-Pointer-Pen-2017-Drop-Shipping/32808900903.html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)

Так же обнаружены очень интересные [UV-VIS свето-диоды](https://www.aliexpress.com/item/32266780769/32266780769.html?shortkey=YRfUjiYZ&addresstype=600)

Прочие полезные статьи и книги:
`TODO`

Snork2, 2017-10-31:
Полезные ссылки

Интересная конструкция спектрометра:
https://www.jandrotek.de/android-apps/aspectra/spectrograph-mini/

Исходники приложения aspectra mini

Closed 2018-01-27.

Thread 3 (2017-10-03):

Выбрать камеру для бортового спектрометра

Snork2, 2017-10-03:
Отлично подходят ПЗС линейки

Например:
[С объективом](https://ru.aliexpress.com/item/New-3V-5V-TSL1401CL-128X1-Linear-CCD-Sensor-Comes-With-Array-With-Hold-Ultra-Wide-Angle/32830818390.html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,searchweb201602_1_10152_10065_10151_10068_10344_10342_10343_10340_10341_10307_10301_10060_10155_10154_10056_10055_10054_10059_10534_10533_10532_100031_10099_10338_10339_10103_10102_10169_10052_10053_10142_10107_10050_10051_10084_10083_10080_10082_10081_10110_10111_10112_10113_10114_143_10312_10314_10078_10079_10128_10073_10129_10125,searchweb201603_12,ppcSwitch_5&btsid=8c49d16c-99f2-492c-8c52-102c2cdaa1fd&algo_expid=ad32d563-db2e-41c8-9c4d-e3665bd47740-0&algo_pvid=ad32d563-db2e-41c8-9c4d-e3665bd47740)

[Без объектива](https://ru.aliexpress.com/item/Free-shipping-5pcs-Lot-TCD1304DG-TCD1304-CDIP22-CCD-LINEAR-IMAGE-SENSOR-IC-100-New-Original-authentic/32388839134.html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,searchweb201602_1_10152_10065_10151_10068_10344_10342_10343_10340_10341_10307_10301_10060_10155_10154_10056_10055_10054_10059_10534_10533_10532_100031_10099_10338_10339_10103_10102_10169_10052_10053_10142_10107_10050_10051_10084_10083_10080_10082_10081_10110_10111_10112_10113_10114_143_10312_10314_10078_10079_10128_10073_10129_10125,searchweb201603_12,ppcSwitch_5&btsid=cb5b8417-7677-4c37-9667-3a007b0c66ad&algo_expid=8c6a2979-6ed0-4856-a5c8-2540ca417d54-3&algo_pvid=8c6a2979-6ed0-4856-a5c8-2540ca417d54)

Однако нужно смотреть на разрешение и возможность управления с нашего МК.

Так же бонусом является возмонжость удаления ИК фильтра

Snork2, 2017-10-17:
Выбрали https://www.aliexpress.com/item/Raspberry-Pi-Camera-Focal-Adjustable-Night-Vision-Camera-Module-for-Raspberry-Pi-2-3-Model-B/32712369636.html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

Closed 2017-10-17.

Thread 6 (2017-10-17):

Определиться с бортовыми вычислителями, их ролями и прочей электронной аппаратурой

Snork2, 2017-10-17:
Или отказаться от него полностью

Snork2, 2017-10-31:
Нужно выбрать контроллер для задач реального времени (вроде тут уже опеределились - open pilot cc3d revo (или nano?)

Следующий шаг: нужно сформировать задачи бортового ПО и разделить их между нашими бортовыми ЭВМ. Так же сформировать список дополнительного оборудования (датчиков, камер и пр.) и так же разделить их между ЭВМ

Closed 2018-01-27.

Thread 7 (2017-10-17):

Построить прототип заборщика почвы и убедиться в его работоспособности

Snork2, 2017-10-17:
На базе архимедова винта

Snork2, 2017-10-31:
Первая версия винта изготовлена (https://github.com/granum-space/cansat-2017-2018/tree/06194209c77ec0ac1664eb357ca14ed37768e431/research/archimedes%20screw)

Испытания показали:

Первый же небольшой камешек заклинил винт. Можно попробовать увеличить конструкцию в целом - и винт и кожух. Это позволит "пережевывать" более большие камни. Можно попробовать уменьшить диаметр оси винта. Однако не понятно как это отразится на процессе печати.

Винт слишком сильно зарывается в грунт, застервает там и тащит "опору" за собой, что может опрокинуть аппарат. Для устранения замечания нужно поработать с "окном" винта в корпусе. Его нужно сделать поменьше, чтобы винт не зарывался на всю ширину рабочей плоскости.

Фаска на краю "окна" на кожухе сделана не в ту сторону. И форма самого окна тоже не верная. Тут нужно смотреть модель. Там вообще не следует делать фасок а просто сделать простой вырез выдавливанием, причем треугольный, а не с дугой, как сделано сейчас. Это обеспечит наилучшее прилегание плоскости среза "окна" к грунту и наилучший забор этого самого грунта. Вообще вопрос с окном очень сложный - его глубина и угол среза очень влияют на работу механизма. Так же угол среза задает угол, под которым механизм должен быть прижат, нужно выяснить как ведет себя винт при отклонениях от этого угла.

Винт "выкручивается" из кожуха и уходит в грунт. Нужно сделать на конце упор, который бы это предотвращал.

Крутить его рукой без моторо очень неудобно, поэтому нужно раздобыть мотор и всетаки приделать держалку для него к кожуху.

Что делать дальше (выводы):

1) Обязательно приделать мотор. С ним гораздо проще крутить винт.

2) Изменить форму окна в кожухе и фаску, заменив последовательность в модели на простое выдавливание треугольника в осевой плоскости. Само окно при этом уменьшить. Это улучшит прилегание кожуха к грунту и не даст винту закапываться.

3) Сделать упор для винта на "рабочем конце" кожуха. Это тоже не даст винту закапываться и "ускользать" из кожуха.

4) Чтобы понять как ведет себя механизм при разных углах прижима - хорошо бы сделать опору, которая позволяла бы обеспечивать этот различный угол прижима, т.к. удержать конструкцию рукой в неподвижном виде довольно тяжело

5) Нужно бы раздобыть дерна, пока все не засыпало снегом, чтобы проверять как ведет себя винт с травой

Closed 2018-01-27.

Thread 10 (2017-10-31):

Опробовать в работе фильтр Маджвика

Snork2, 2017-10-31:
Запрограммировать драйвера для наших новых датчиков и попробовать фильтр Маджвика

Общее описание алгоритма: https://habrahabr.ru/post/255661/

Рефренсная имплементация на Си доступна здесь: http://x-io.co.uk/open-source-imu-and-ahrs-algorithms/

Closed 2018-01-27.

Thread 11 (2017-10-31):

Разработать гидравлический контур для растворения и доставки грунта в спектрометр

Snork2, 2017-10-31:
Разработать гидравлический контур для растворения и доставки грунта в спектрометр

1) Нужно разработать и описать сам контур.

2) Согласно статьям из #1, грунт для ислледований растворяют щелочью. Нужно найти щелочь и определиться с концентрацией.

3) Найти и выбрать трубки для жидкостей. Ключевые параметры: диаметр и материал. Выбранный диаметр влияет на все остальные элементы системы.

4) Найти и выбрать резервуары для жидкостей. В том числе и кюветы для спектроскопии. На первый взгляд предпочтительными являются кюветы из PMMA. Они не хрупкие, легко режуться и пропускают УФ.

5) Найти и выбрать фиттинги и муфты для трубок.

6) Найти и выбрать перистальтический насос.

7) Найти и выбрать электромеханические клапаны (если требуются).

### Полезные ссылки:

Электромеханические клапаны: [раз](http://s.aliexpress.com/jQN3e6Jv), [два](http://s.aliexpress.com/yU3U36Zn)

Фиттинги: [раз](https://www.aliexpress.com/item/Stainless-steel-304-single-ferrule-tee-tube-fitting/32826498623.html).

Closed 2018-01-27.

Thread 9 (2017-10-31):

Найти в продаже и купить кюветы для спектрометра

Snork2, 2017-10-31:
Лучше всего подходят кюветы из материала под названием PMMA. Они не бьются, так как пластиковые и в неплохой степени пропускают УФ.

Snork2, 2017-10-31:
Интегрировано в #11

Closed 2017-10-31.
