granum-space/cansat-2017-2018/schematics/fusesBoard.pdf

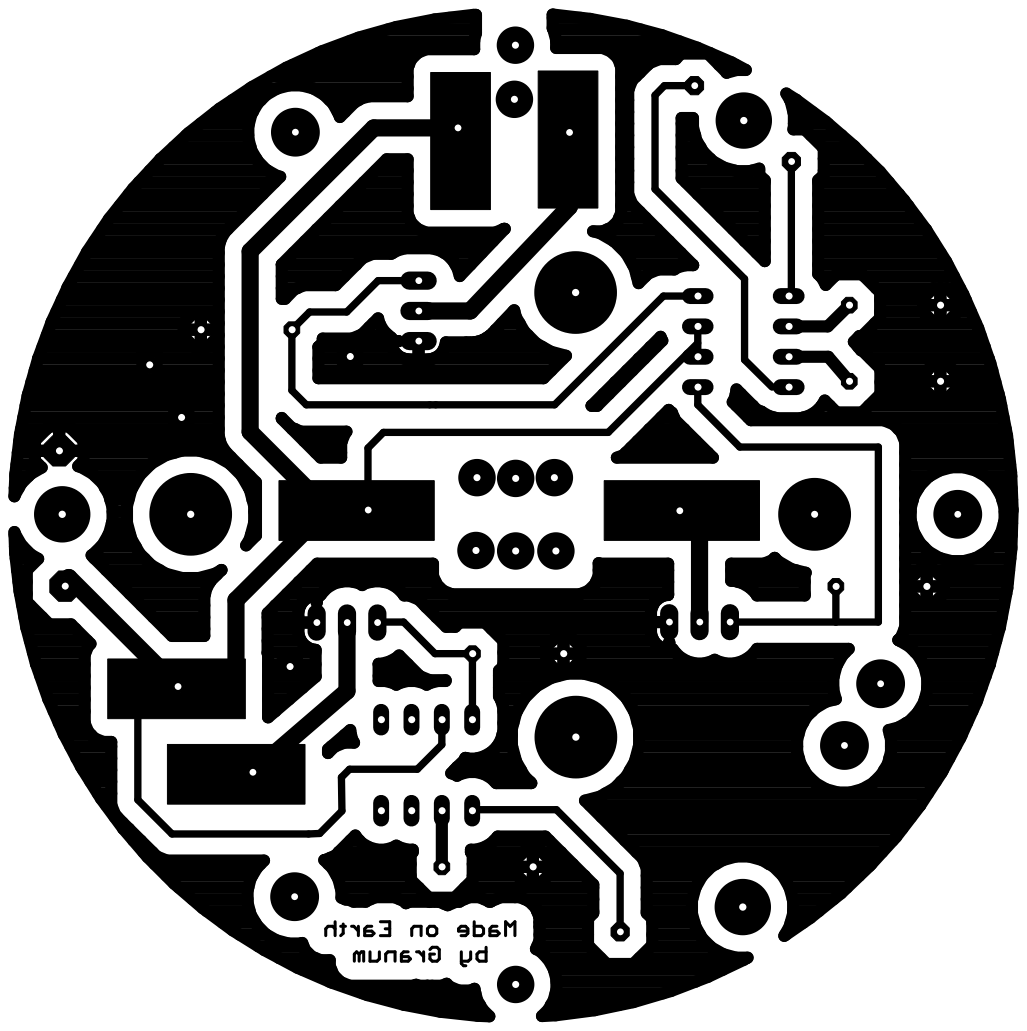
[picture p71: page 1]
