granum-space/cansat-2017-2018/schematics/fusesBoard.brd

## EAGLE design schematics/fusesBoard.brd (2018-04-22)

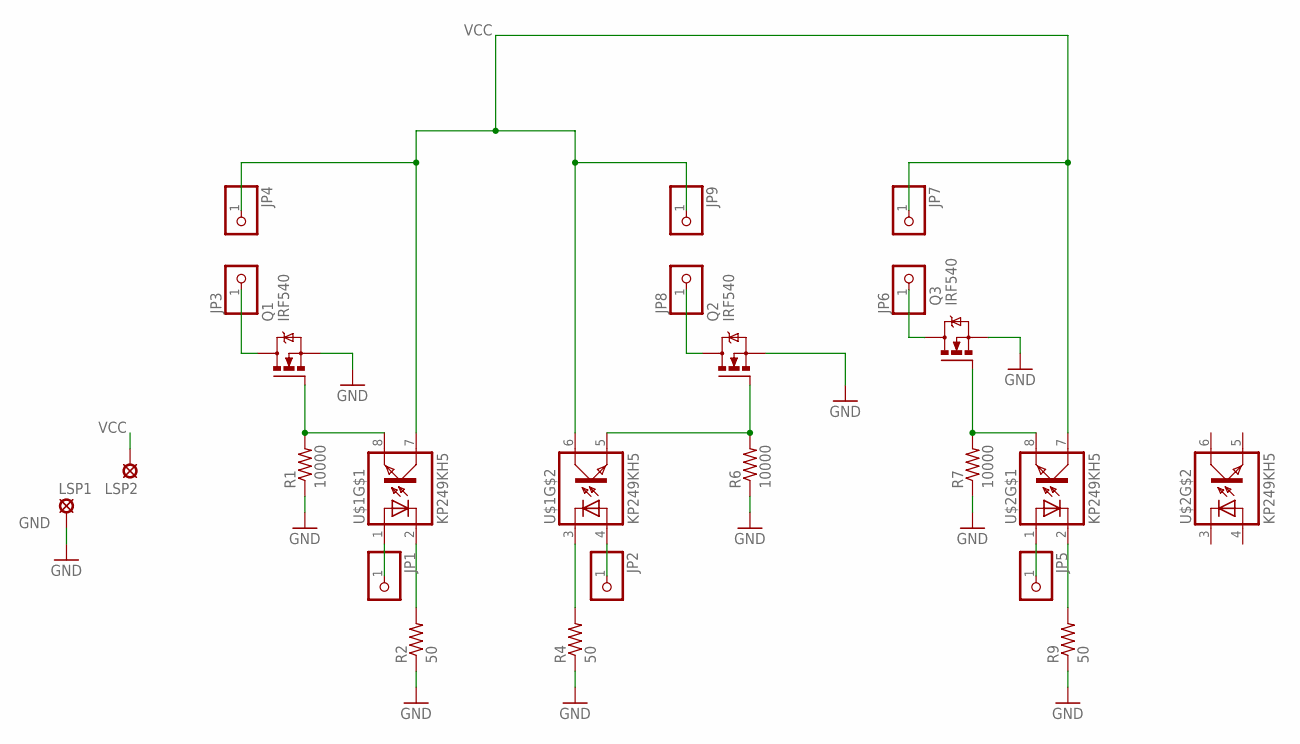
[picture p72: schematic fusesBoard.sch]

Parts:
JP1, JP2, JP3, JP4, JP5, JP6, JP7, JP8, JP9: PINHD-1X1; 1X01
LSP1, LSP2: SE14
Q1, Q2, Q3: IRF540; TO220BV
R1, R6, R7: 10000; 0204/7
R2, R4, R9: 50; 0204/7
U$1, U$2: KP249KH5; DIL08

Connections:
CTRL1: JP1.1, U$1.1
CTRL2: JP2.1, U$1.4
CTRL3: JP5.1, U$2.1
GATE1: Q1.G, R1.2, U$1.8
GATE2: Q2.G, R6.2, U$1.5
GATE3: Q3.G, R7.2, U$2.8
GND: LSP1.MP, Q1.S, Q2.S, Q3.S, R1.1, R2.1, R4.1, R6.1, R7.1, R9.1
unnamed: R2.2, U$1.2
unnamed: R9.2, U$2.2
unnamed: R4.2, U$1.3
SOURCE1: JP3.1, Q1.D
SOURCE2: JP8.1, Q2.D
SOURCE3: JP6.1, Q3.D
VCC: JP4.1, JP7.1, JP9.1, LSP2.MP, U$1.6, U$1.7, U$2.7

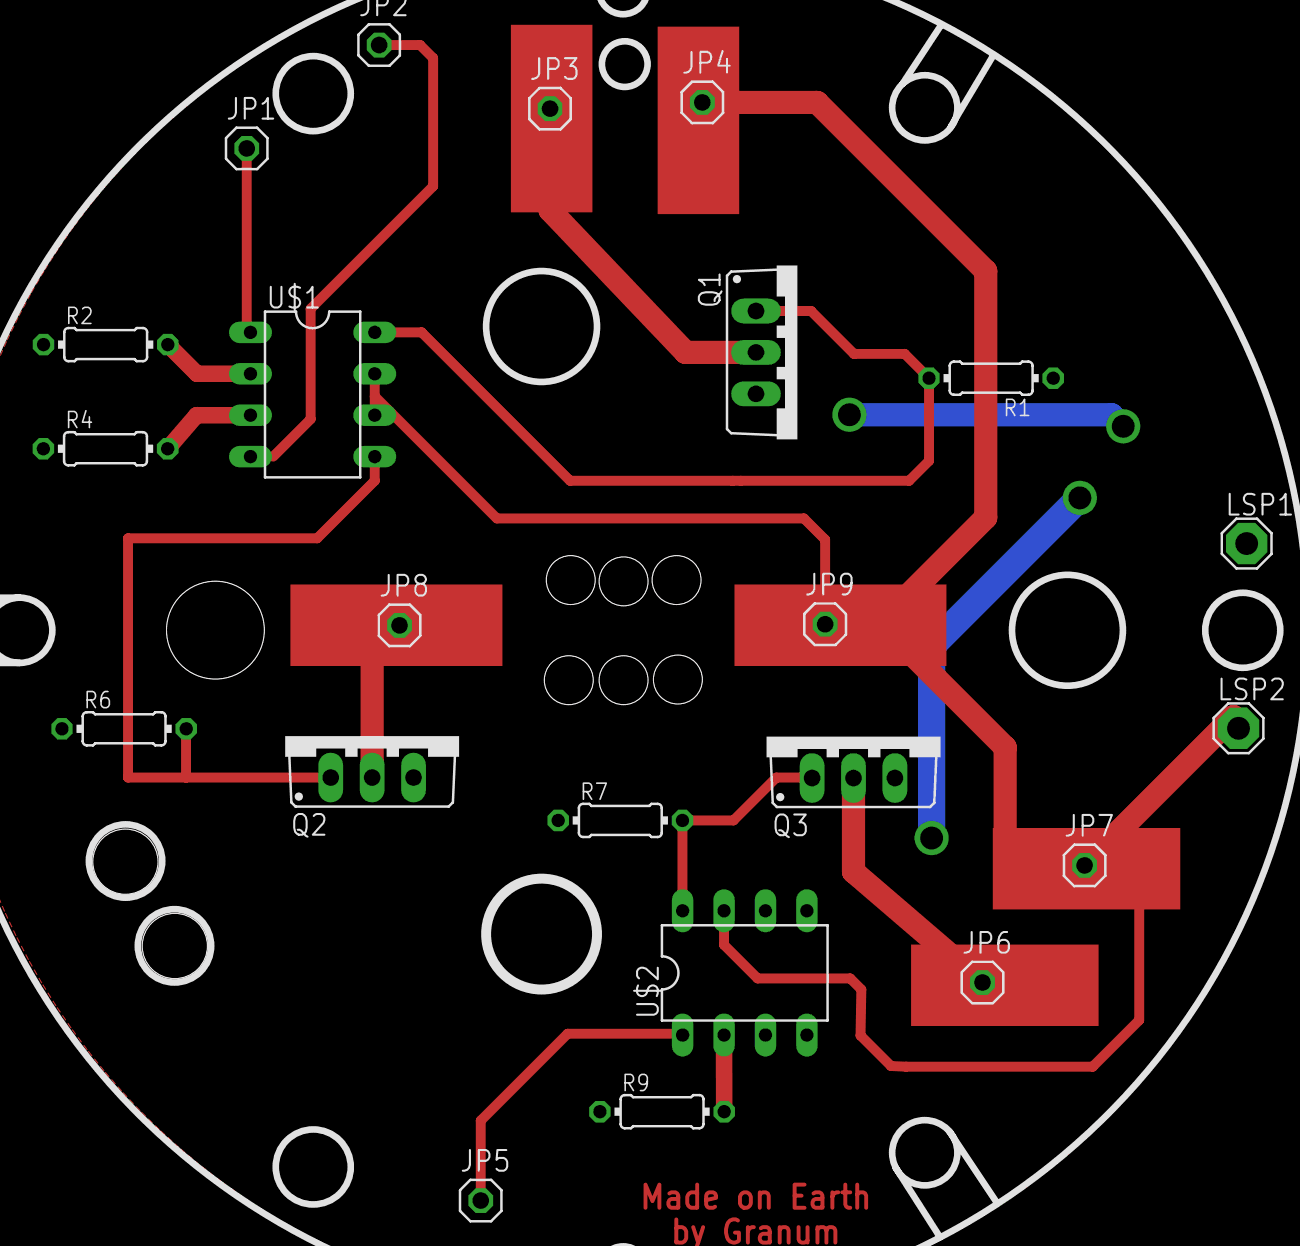
[picture p73: board fusesBoard.brd from above]

Board: 2 copper layers, 22 parts (0 on the bottom side), 14 nets.
