granum-space/cansat-2017-2018/research/omnubus-reborn/src/bmp280_local.h

/*
 * bmp280_local.h
 *
 *  Created on: 5 янв. 2018 г.
 *      Author: snork
 */

#ifndef BMP280_LOCAL_H_
#define BMP280_LOCAL_H_

#include <bmp280.h>

void bmp280_local_init(struct bmp280_t * device);

#endif /* BMP280_LOCAL_H_ */
