granum-space/cansat-2017-2018/(commit log)

2017-10-31 Создана структура каталогов и загружены модели архимедового винта
    [archimedes_case.prt, vint.prt]
2017-10-31 забытые детали архимедового винта и спектрометр
    [cameradet.prt, casing.prt, casing_motor.prt, motor.prt, plastinka.prt, spectrometr1.prt, spectrometr_top.prt]
2017-11-06 Добавлен тест фильтра Маджвика
    [theplane.stl]
2017-11-16 частично готовый, полностью переработанный спектрометр
    [camdet_down.prt, camera.prt, cameradet.prt, grating.prt, grating_cover.prt, plastinka.prt, slit.prt, spectrometer-base-bottom.prt]
2017-11-16 чертеж для щели
    [slit.prt]
2017-11-20 Перенес конструкцию в отдельный каталог
    [camdet_down.prt, camera.prt, grating.prt, grating_cover.prt, slit.prt, spectrometer-base-bottom.prt, spectrometer-base-top.prt]
2017-11-20 Добавил черновую версию сервера для спектрометра
2017-11-23 Сервер упрощен и проверен
2017-11-23 Клиент показывает картинку!
2017-11-23 Добавил структурную схему
2017-11-24 Относительно приемлимо работает. Об измерении спектра речи пока не идет
2017-11-28 Код волосатый, но завтра можно будет работать
2017-11-28 Добавил возможность "заморозки" графика для сравнений
2017-11-28 Косяк с компиляцией (Несколько непонятный, нужно будет разобраться)
2017-12-23 Добавлен экспорт графика в файл, починены перепутанные цвета
2017-12-23 Добвалены (не доделаны) слайдеры настроек
2017-12-24 Реализовано растяжение гистограммы яркости, улучшены слайдеры
2017-12-27 Add files via upload
    Помимо основной схемы добавлено разделение бортового комплекса управления(БКУ), а именно:
    /* внимание: дальше будет много аббревиатур */
    СЭП - система электропитания
    СУДН - система управления движением и навигацией
    СУБА - система управления бортовой аппаратурой
    БРК - бортовой радио комплекс
    БВС - бортовая вычислительная система
    ПН - полезная нагрузка
2017-12-30 наброски контейнера для парашюта
2017-12-30 в архитектуре подправлены недочеты
    и добавлены фотографии компонентов
2017-12-30 а вот и фотографии
2017-12-30 Начата "Нежность", добавлена схема ПО
2018-01-05 Проект для теста работы с омнибасом. Настроен на работу с FPU и прочим. Очень сырой и корявый
2018-01-07 Нежность, старые модели, изменения в архитектуре
    [cam_case.stl, cam_cover.stl, camdet_down.stl, grating_cover.stl, spectrometer-base-bottom.stl, spectrometer-base-top.stl]
2018-01-10 Навел порядок с картинками
2018-01-10 Схемы
2018-01-13 Нафоткано
2018-01-16 спектрометр на слайды
2018-01-16 поправил схему БРКэ
2018-01-17 Фотографии возвращены в отделную папку
2018-01-17 В этом файле ПО переделано под презентацию
2018-01-17 Последние изменения
2018-01-18 Переведена схема ПО для ПЗ, пофикшена тень текста в ПО для презентации
2018-01-20 Исправил схему БКУ
2018-01-21 Добавил общие модели
    [seeds_servo.prt]
2018-01-21 Убрал старые версии
    [cam_case.stl, cam_cover.stl, camdet_down.stl, grating_cover.stl, spectrometer-base-bottom.stl, spectrometer-base-top.stl]
2018-01-21 Намоделено немного электроники, сделал для неё папочку, переместил туда батарейку
2018-01-21 Омнибас доработан по натурной модели
2018-01-21 Добавил модель сонара
2018-01-21 Исправил оптическую схему под новые веяния
2018-01-22 Auto stash before merge of "master" and "origin/master"
    Правим схемы
2018-01-22 Линзы для ПЗ
2018-01-22 Продолжаем править схемы
2018-01-22 Черновая модель системы "Зацепка"
    [zond.prt]
2018-01-23 Затравка для отсека для парашюта
2018-01-24 пофикшен БКУ
2018-01-25 Картиночки да схемочки, схемочки да картиночки!
2018-01-27 Конструкция готова!(почти)
    [seeds_servo.prt, zond.prt]
2018-01-27 ПЗ, которая ушла на печать
2018-01-27 компановка
2018-01-27 удаленные
2018-01-28 Разбил схемы спектрометра на две. Вроде как навел порядок в структуре?
    [camdet_down.prt, camera.prt, grating.prt, grating_cover.prt, slit.prt, spectrometer-base-bottom.prt, spectrometer-base-top.prt]
2018-01-28 Сборки с поддержками для печати частей спектрометра
    [spectro_base_bottom_print.stl, spectro_base_top_print.stl]
2018-02-10 Начата работа над единой абстракцией для единообразного доступа к внешним устройствам
2018-02-17 Вырисовывается чёткая структура devctl
2018-02-21 Devctl почи закончен (осталось протестировать и добавить работу с потоковыми интерфейсами)
2018-02-21 новый отсек системы спасения на печать.
2018-03-03 Многое поправлено, начата тестовая интеграция с драйвером BMP
2018-03-10 конструкция
2018-03-10 Реструктуризация каталогов
2018-03-10 Добавил nuttx
2018-03-10 Добавил apps из чистого nuttx 7.24 https://bitbucket.org/nuttx/apps/commits/0b3ce51a0ed61da3048d8611a70d7280132ae513
2018-03-10 добавил папочку с "нашими" приложениями
2018-03-11 Удалил старые каталоги и начал добавлять поддержку мавлинка
2018-03-11 Добавил наш форк мавлинка
2018-03-11 Мейкфайл для генерации мавлинковски сообщений
2018-03-11 Добавил тестовое кастомное сообщение и пару тестовых програмок на питоне и на си
2018-03-16 моя версия драйвера
2018-03-17 последняя версия конструкции с передаланными платформой, отсеком СС, все еще с зеркалами
    [new_platform.stl, new_thehope_cover.stl, platform.stl]
2018-03-17 к ОСС добавлен текстолит с двумя пережигалками, осталось только сделать пережигалку на зацепку и можно на печать
2018-03-17 Навел порядок с версионированием моделей (и сделать скрипт для этого)
    [am2320.prt, antenn.prt, battery_case.prt, battery_new.prt, bottom-plane_new.prt, bottom-plane_nnew.prt, cam_cover_neww.prt, camdet_down_new.prt]
2018-03-18 Перемоделил нижный отсек
    [am2320.prt, battery_base.prt, battery_case.prt, battery_new.prt, bottom-plane_new.prt, camera_cmos.prt, electronics_new.prt, electronics_new1.prt]
2018-03-18 Дырки для доставания батарейки
    [battery_case.prt]
2018-03-23 Добавил шаблон проекта для stm8 на sdcc из https://community.st.com/docs/DOC-1963-my-project
    [stm8af52ax.stp, stm8af622x.stp, stm8af626x.stp, stm8af62ax.stp, stm8s003.stp, stm8s005.stp, stm8s007.stp, stm8s103.stp]
2018-03-23 Добавил проект для сервы (с эклипсом), удалил лишнее
2018-03-24 плата для пережигателей расчерчена под особенности аппарата
    [fusesBoard.brd, fusesBoard.sch]
2018-03-24 привели в порядок nuttx репозиторий повторный коммит сонара
2018-03-25 готова схема платы с пережигателями
    [fusesBoard.brd, fusesBoard.sch]
2018-03-25 Работы над тестом NRF
2018-03-25 код для сервы
2018-03-26 NRF доведён до рабочего состояния
2018-03-27 разведена плата для пережигателей
    [fusesBoard.brd, fusesBoard.sch]
2018-03-28 продолжение работы с сонаром. консоль заработала, а драйвер почти заработал
2018-03-30 Закончен тест НРФа
2018-03-31 сонар доведен до рабочего состояния, warnings устранены.
2018-03-31 обновился nuttx
2018-04-11 сделаны площадки под пережигатели, увеличена ширина дорожек
    [fusesBoard.brd, fusesBoard.sch]
2018-04-14 код для сервы на i2c
2018-04-17 Затравки наземки
2018-04-18 К черту sql, будет redis
2018-04-19 Потому что редис - это круто
2018-04-20 Затравочка для приёмной станции
2018-04-21 Тесты мпу и минмеа
2018-04-21 переразведенная схема платы
    [fusesBoard.brd, fusesBoard.sch]
2018-04-21 последняя версия модели перед печатью для видео
    [battery_base.prt, battery_case.prt, bottom-plane_new.prt, bottom-plane_new.stl, den1.prt, den12.prt, electronics_new.prt, electronics_new1.prt]
2018-04-22 made on earth
    [fusesBoard.brd, fusesBoard.sch]
2018-04-22 Поддержки для окошка для пережигателя и ремонт самого окошка
    [antenna_gps.prt, battery_base.prt, battery_case.prt, battery_protection.prt, beeper.prt, bottom-plane_new.prt, camm_kron.prt, den1.prt]
2018-04-22 Сделал графики для ускорения и дуса. немножечко отстилизовал
2018-04-22 Особенности перезда на сервер
2018-04-23 Тестовый эмиттер теперь может давать "телеметрию" не только на локалхост Мавлинковское приложение слушает не только локалхост
2018-04-23 Добавил юниты для systemd
2018-04-23 Попытка починить логи, чтобы systemd не смывало потоком
2018-04-23 модель после поломки
    [new_chute2_case.prt, new_chute2_case.stl, sp.prt, textolit.prt]
2018-04-25 Пробы графиков
2018-04-25 Борт отправляет данные IMU
2018-04-25 Переделки, чтобы каждый раз отдавать только новые записи и переход на свои сообщения для MPU6000
2018-04-27 Добавил считалку углов дифрешетки
2018-04-27 Наземка переделана, чтобы отсылать клиенту только новые записи
2018-04-29 Теперь можно компилить и на донную нанопи
2018-04-29 Доделан BMP, начата карта
2018-04-30 Линии, рисующиеся из редиса и поповеры по ним
2018-04-30 С борта отправляются пакеты gps
2018-05-01 Починил графики, доделал карту
2018-05-01 Начата интеграция сонара
2018-05-01 Затравочка под webgl
    [rocket.stl]
2018-05-02 Сонар добит
2018-05-02 Ракета интегрирована в плотсы
2018-05-04 Попытка Маджвика (не пытка)
2018-05-12 Ещё одна неудачная пытка в маджвика
2018-05-18 Доделан Маджвик
2018-05-18 Продолжаем работу над датчиком освещенности
2018-05-18 Работающий пример датчика влажности и температуры
2018-05-18 Исправлены опечатки и забывайки
2018-05-18 Добавил конфигурацию, в которой проект наиболее близок к тому, чтобы собираться
2018-05-19 Датчик освещенности работает! Представляете?
2018-05-20 Первая степень готовности к испытаниям
2018-05-21 Телеметрия с тестового пуска и скрипты для её обработки и проигрывания
2018-05-22 Телеметрия с сегодняшнего полета
    [ATTITUDE_QUATERNION.csv, BAD_DATA.csv, SCALED_IMU.csv, SCALED_PRESSURE.csv]
2018-05-26 Состояние на момент 2 и 3 запуска
2018-05-26 Дописан и оттестирован драйвер lsm303c
2018-05-26 Начата "лепка" финального кода
2018-05-27 другой вариант спектрометра
    [antenna_gps.prt, battery_base.prt, battery_case.prt, battery_protection.prt, beeper.prt, bottom-plane_new.prt, camera_neww.prt, camm_kron.prt]
2018-05-29 предварительный вариант отсека сс
    [new_chute2_case.prt]
2018-05-29 Перенесено окошко для бокового пережигателя и сделаны отверстия для проводов
    [new_chute2_case.stl]
2018-05-31 Расписаны все треды, осталось тестирование, разбор пакетов от малинки и главный поток управления
2018-06-02 Начат перенос программы для спектров на rpi
    [config.txt]
2018-06-02 доработки по аппарату
    [battery_base.prt, battery_case.prt, bottom-plane_new.prt, camm_kron.prt, den1.prt, electronics_new.prt, electronics_new1.prt, new_chute2_case.prt]
2018-06-02 Попытки переехать на modwsgi
2018-06-03 Попытка переосмысления тела спектрометра
2018-06-04 Теперь в миллиметрах
2018-06-04 Обновление ресурсов переведено на таймауты, моделька кансата вместо ракеты
    [cansat.stl]
2018-06-10 Бортовой код доведён до запуска
2018-06-12 теперь все запускается под gunicorn
2018-06-13 Пофикшен баг с ОВЕРЧЕРЕЗМЕРНЫМ потреблением CPU из-за модельки, тест динамического обновления картинок
2018-06-13 Улучшено оформление
2018-06-14 добавлен файл для получения и сохранения
    телеметрии со спектрами и картинкой
2018-06-15 переписала датчик влажности и температуры на python
2018-06-16 добавлен модуль для взаимодействия с am2320
    передача и прием телеметрии по мавлинку (еще не тестила)
2018-06-17 Перенос датчика влажности в отдельную папку
2018-06-17 не закоммиченные ранее мавлинсковские сообщения для данных от камеры спектрометра и датчика влажности, температуры
2018-06-17 работает передача и прием данных от am2320 по мавлинку
2018-06-17 в сообщениях изменен тип для времени из-за возникающего переполнения
2018-06-17 Текущие изменения кода
2018-06-17 Эксперименты со звуком
2018-06-20 Наработки по звуку
2018-06-21 Сделан стриминг звука (на /sound)
2018-06-21 Добавлен скомпиленный на бортовой малинке драйвер i2s
2018-06-22 расшифровка мавлинковских сообщений и сохранение данных в csv сообщения со спектрами сохраняются по-своему, чтобы легче строить графики в granum.xml добавила поле для положения сервы
    [mega.csv]
2018-06-22 файлы для обработки данных уже после полета: программа для подсчета интенсивностей со снимка спектра и программа для построения трехмерной поверхности по мавлинковским сообщениям, связанным со спектр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
2018-06-22 Акцепторы спектров вынесены в отдельные классы
2018-06-22 Сделан вывод спектров на сайт
2018-06-23 откалибровали спектрометр, теперь графики строим от нанометров, а не от строчек. добавила более точную функцию перевода нанометров в RGB, чтобы график был более наглядным
2018-06-24 добавила поле, обозначающее координату по Y обрезки снимка спектра
2018-06-24 Текущие изменения
2018-06-24 добавила работающие сервисы для спектрометрии и датчика влажности/температуры на raspberry pi
2018-06-24 Добавлены сервисы с pharos
2018-06-24 поправила максимумы для графиков, добавила комментарии; оставшееся с калибровки: csv-файлы с графиками лазеров, программа для подсчета нанометров в зависимости от строчки картинки
    [405.csv, 450.csv, 532.csv, 650.csv, nm_from_row.csv]
2018-06-24 добавила декодировку и сохранение картинок по логам от мавлинка
2018-06-25 Исправлены ошибке в модуле звука
2018-06-25 Исправлены проблемы с висящими сокетами
    [__main__.py]
2018-06-27 построение графиков по картинкам из логов мавлинка
2018-06-27 NRF работает LSM не работает
2018-06-27 Обобщенный проект для работы над прошивкой
2018-06-28 Заигнорил лишнее
2018-06-28 В конструкциях сделана FSM
2018-06-29 в тысячный раз переделанная конструкция аппарата, но нутром чую, что окончательная. Ура, товарищи!
    [camm_kron.prt, camm_kron1.prt, electro_platform.prt, electronics_new.prt, electronics_new1.prt, lens_bottom_case.prt, pipe_holder1.prt, serva.prt]
2018-06-29 построение графиков спектра отражения
2018-06-29 юнит для автоматической настройки камеры при включении raspberry pi
2018-06-29 Оформлен модуль звука
2018-06-29 добавлен юнит для звукового модуля на raspberry pi. в связи с перемещением всех модулей в /opt также подправлены остальные юниты
2018-06-30 Текущие изменения в сообщениях
2018-07-01 Поддержка службы дефрагментирующей пакеты
2018-07-01 исправление ошибок в отображении 3д модели
2018-07-02 Много изменений
2018-07-02 Текущие фиксы
2018-07-02 Добавлены все графики, подправлена разметка
2018-07-02 Рефакторинг блюпринтов
2018-07-03 Изменения
2018-07-03 Готовность к предстаротовым
2018-07-03 Добавлено онлайн отображение статуса аппарата
2018-07-03 Изменены параметры логгирования дефрагментатора (Василий)
2018-07-03 Правки к графикам
2018-07-03 Состояние перед проверкой аппарата
2018-07-04 логи для фароса
2018-07-04 программа для работы с сервой на raspberry pi
2018-07-04 логи везде 5~везде
2018-07-04 телеметрия с наземной станции
2018-07-05 Результаты
    [ATTITUDE_QUATERNION.csv, GRANUM_STATUS.csv, LUMINOSITY.csv, SCALED_IMU.csv, SCALED_PRESSURE.csv, SONAR.csv]
2018-07-05 Обработка результатов полета
    [ATTITUDE_QUATERNION.csv, cansat.stl]
2018-07-05 Из видео удалено лишнее и добавлен список зависимостей для плоттера ориентации
2018-07-07 презентация с летней сессии
2018-07-09 С подготовки презентации
    [SCALED_IMU.csv]
2018-07-10 Последние изменения перед запуском
2019-01-11 презентации с зимней сессии (чтобы не потерялись)
